AleksWolf/kryakva/docs/datasheets/README.md

# Manufacturer documents

The manufacturer documents are published unchanged. The rights to them belong to the manufacturers.

| File | What | Source |
|---|---|---|
| [radxa_zero_3w_3d_stp.zip](radxa_zero_3w_3d_stp.zip), [radxa_zero_3w_2d_dxf.zip](radxa_zero_3w_2d_dxf.zip) | 3D STEP and 2D DXF of the Radxa Zero 3W board (v1.11) | Radxa, dl.radxa.com |
| [camera_8m_219_product_brief.pdf](camera_8m_219_product_brief.pdf) | description of the Radxa Camera 8M 219 camera (IMX219) | Radxa, dl.radxa.com |
| [UC01-V1.6-SCH.pdf](UC01-V1.6-SCH.pdf) | schematic of the UC-01 servo bus board (v1.6) | Fashion Star, fashionstar.com.hk/wiki |
| [DS_vl53l8cx.pdf](DS_vl53l8cx.pdf) | datasheet of the VL53L8CX ToF sensor | STMicroelectronics |
| [feetech_hd1910/HD-1910-C001串型规格书-20260907.pdf](feetech_hd1910/HD-1910-C001串型规格书-20260907.pdf) | HD-1910-C001 servo specification (Chinese) | Feetech, from JoyandAI/OpenMicroDuck |
| [feetech_hd1910/HD-1910M-C001-drawing-20260902.pdf](feetech_hd1910/HD-1910M-C001-drawing-20260902.pdf) | HD-1910 outline drawing | Feetech, from JoyandAI/OpenMicroDuck |
