AleksWolf/kryakva/docs/datasheets/README.ru.md

# Документы производителей

Документы производителей выложены без изменений. Права на них принадлежат производителям.

| Файл | Что | Источник |
|---|---|---|
| [radxa_zero_3w_3d_stp.zip](radxa_zero_3w_3d_stp.zip), [radxa_zero_3w_2d_dxf.zip](radxa_zero_3w_2d_dxf.zip) | 3D STEP и 2D DXF платы Radxa Zero 3W (v1.11) | Radxa, dl.radxa.com |
| [camera_8m_219_product_brief.pdf](camera_8m_219_product_brief.pdf) | описание камеры Radxa Camera 8M 219 (IMX219) | Radxa, dl.radxa.com |
| [UC01-V1.6-SCH.pdf](UC01-V1.6-SCH.pdf) | схема платы шины серв UC-01 (v1.6) | Fashion Star, fashionstar.com.hk/wiki |
| [DS_vl53l8cx.pdf](DS_vl53l8cx.pdf) | даташит ToF-датчика VL53L8CX | STMicroelectronics |
| [feetech_hd1910/HD-1910-C001串型规格书-20260907.pdf](feetech_hd1910/HD-1910-C001串型规格书-20260907.pdf) | спецификация сервы HD-1910-C001 (кит.) | Feetech, из JoyandAI/OpenMicroDuck |
| [feetech_hd1910/HD-1910M-C001-drawing-20260902.pdf](feetech_hd1910/HD-1910M-C001-drawing-20260902.pdf) | габаритный чертёж HD-1910 | Feetech, из JoyandAI/OpenMicroDuck |
