AleksWolf/kryakva/hardware/cables.md

# Servo bus cables

19 AMP 2.0-3P cables, pin to pin (1–1, 2–2, 3–3): 9 from the servo boxes (15 cm), the rest as listed in [bom.md](bom.md).
For your own cables: 24 AWG wire, insulation no thicker than 1.50 mm (for the A2007-T terminal), A2007H-3P housings.

| No. | Chain | From → to | Cable | Qty |
|---|---|---|---|---|
| 1 | leg (L and R) | PCB L / R → hip yaw (ID 20 / 10) | 4 cm | 2 |
| 2 | leg | yaw → hip roll (20→21, 10→11) | 15 cm (from the box) | 2 |
| 3 | leg | roll → hip pitch (21→22, 11→12) | 15 cm (from the box) | 2 |
| 4 | leg | hip pitch → knee (22→23, 12→13) | 6 cm | 2 |
| 5 | leg | knee → ankle (23→24, 13→14) | 15 cm (from the box) | 2 |
| 6 | leg | PCB L PWR / R PWR → free port of the ankle (24 / 14) | 20 cm | 2 |
| 7 | head | UC-01 port 1 → beak (34) | 15 cm (from the box) | 1 |
| 8 | head | beak → head roll (34→33) | 15 cm (from the box) | 1 |
| 9 | head | roll → head yaw (33→32) | 6 cm | 1 |
| 10 | head | yaw → head pitch (32→31) | 15 cm (from the box) | 1 |
| 11 | head | head pitch → neck pitch (31→30) | 4 cm | 1 |
| 12 | UC-01 power | UC-01 port 2 → PCB, UC-01 connector | 25 cm | 1 |
| 13 | neck power | PCB pads → free port of servo 30; connector on the servo end only | 9 cm | 1 |
