AleksWolf/kryakva/hardware/cables.ru.md

# Кабели шины серв

19 кабелей AMP 2.0-3P, контакт в контакт (1–1, 2–2, 3–3): 9 из коробок серв (15 см), остальные — по списку в [bom.md](bom.ru.md).
Для своих кабелей: провод 24 AWG, изоляция не толще 1.50 мм (под клемму A2007-T), корпуса A2007H-3P.

| № | Цепочка | Откуда → куда | Кабель | Шт. |
|---|---|---|---|---|
| 1 | нога (L и R) | PCB L / R → рыскание бедра (ID 20 / 10) | 4 см | 2 |
| 2 | нога | рыскание → крен бедра (20→21, 10→11) | 15 см (из коробки) | 2 |
| 3 | нога | крен → тангаж бедра (21→22, 11→12) | 15 см (из коробки) | 2 |
| 4 | нога | тангаж бедра → колено (22→23, 12→13) | 6 см | 2 |
| 5 | нога | колено → голеностоп (23→24, 13→14) | 15 см (из коробки) | 2 |
| 6 | нога | PCB L PWR / R PWR → свободный порт голеностопа (24 / 14) | 20 см | 2 |
| 7 | голова | UC-01 порт 1 → клюв (34) | 15 см (из коробки) | 1 |
| 8 | голова | клюв → крен головы (34→33) | 15 см (из коробки) | 1 |
| 9 | голова | крен → рыскание головы (33→32) | 6 см | 1 |
| 10 | голова | рыскание → тангаж головы (32→31) | 15 см (из коробки) | 1 |
| 11 | голова | тангаж головы → тангаж шеи (31→30) | 4 см | 1 |
| 12 | питание UC-01 | UC-01 порт 2 → PCB, разъём UC-01 | 25 см | 1 |
| 13 | питание шеи | площадки PCB → свободный порт сервы 30; вилка только со стороны сервы | 9 см | 1 |
