AleksWolf/kryakva/docs/images/duck_back.png

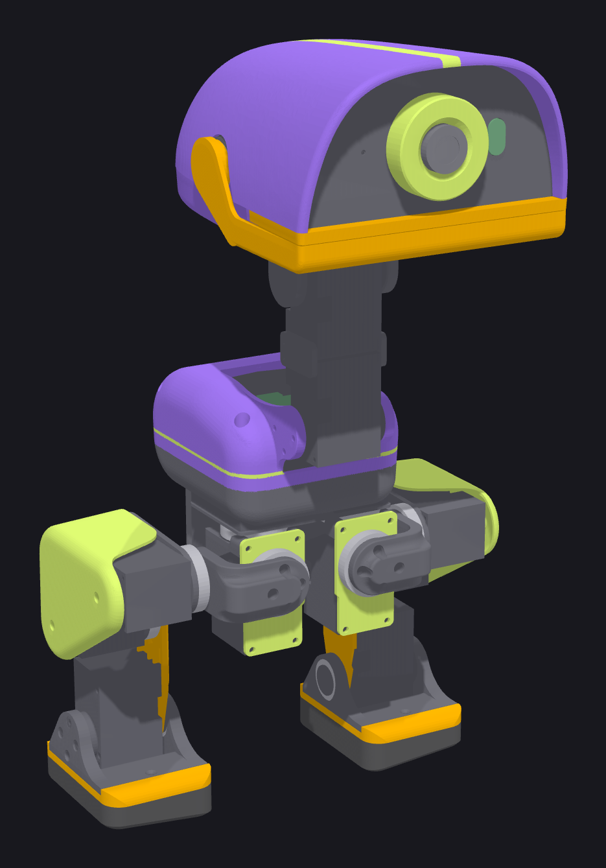
docs/images/duck_back.png
