AleksWolf/kryakva/hardware/images/amp20_header.png

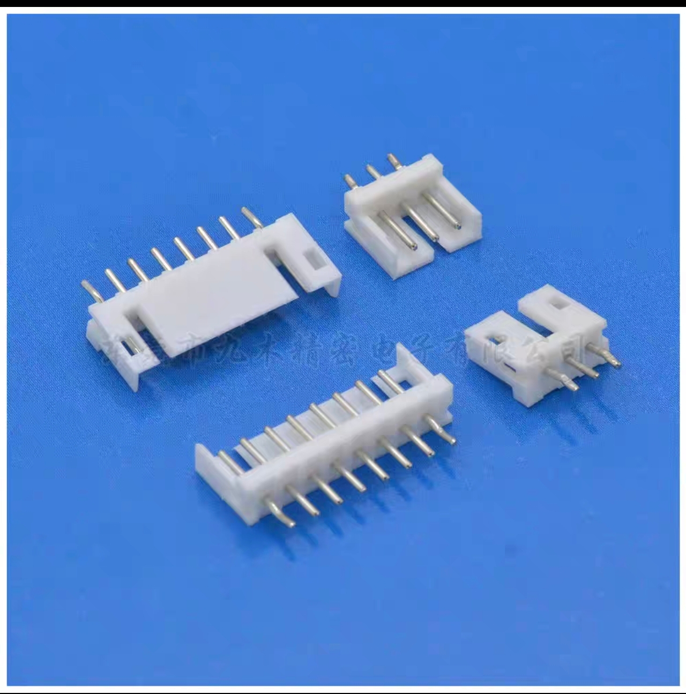
hardware/images/amp20_header.png
