AleksWolf/kryakva/hardware/images/bearing_6700.png

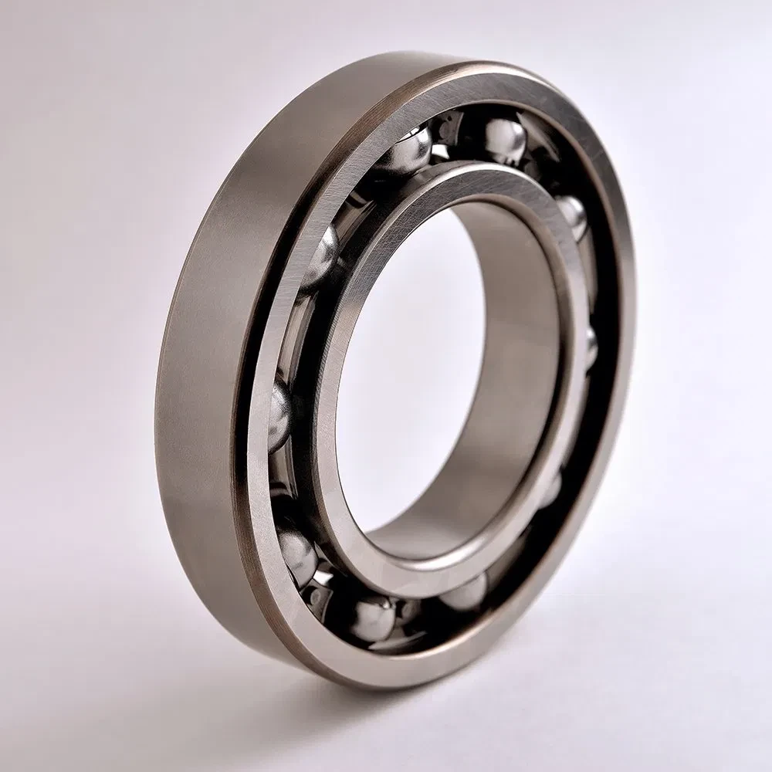
hardware/images/bearing_6700.png
