AleksWolf/kryakva/hardware/images/camera8m219.png

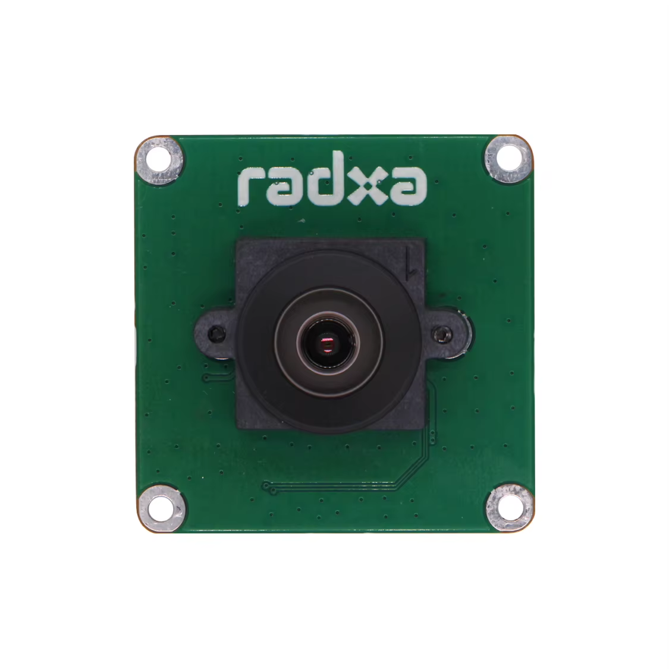
hardware/images/camera8m219.png
