AleksWolf/kryakva/hardware/images/gamepad.png

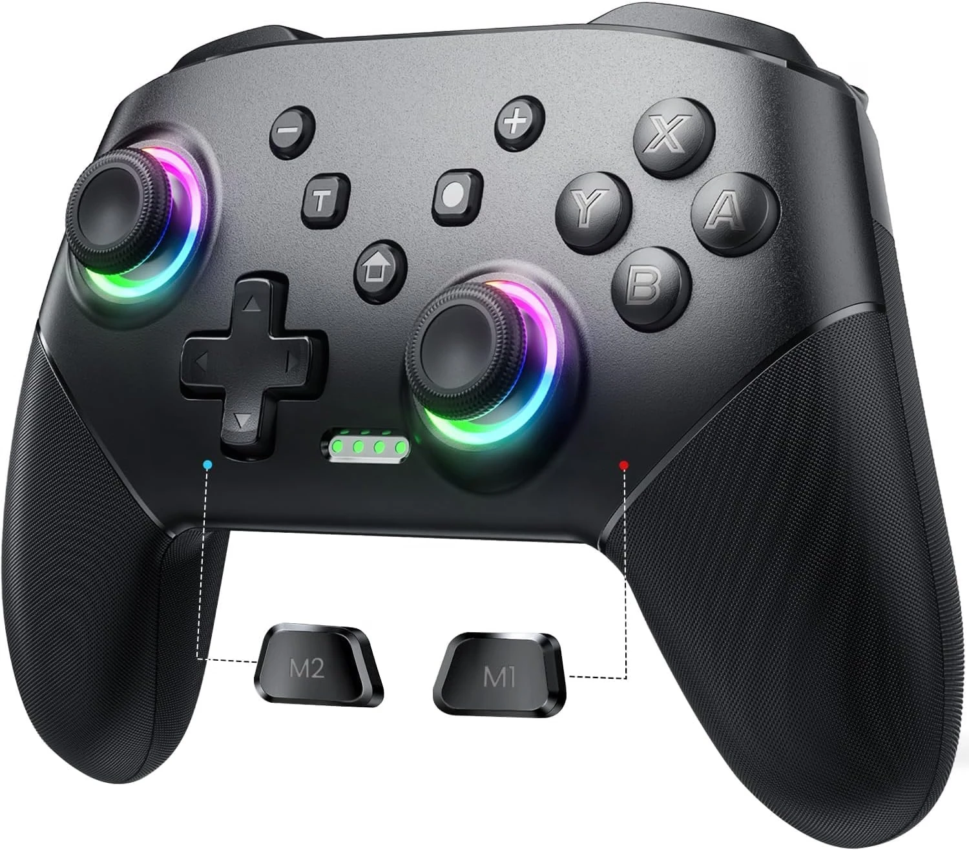
hardware/images/gamepad.png
