AleksWolf/kryakva/hardware/images/hd1910.png

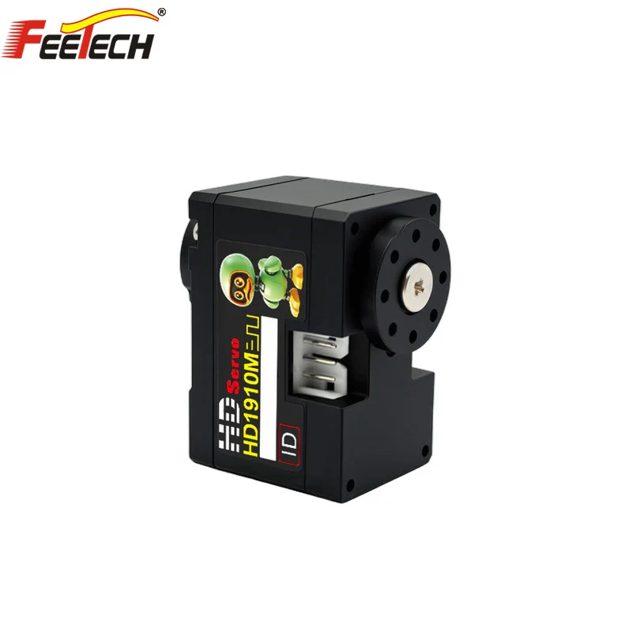
hardware/images/hd1910.png
