AleksWolf/kryakva/hardware/images/heat_insert.png

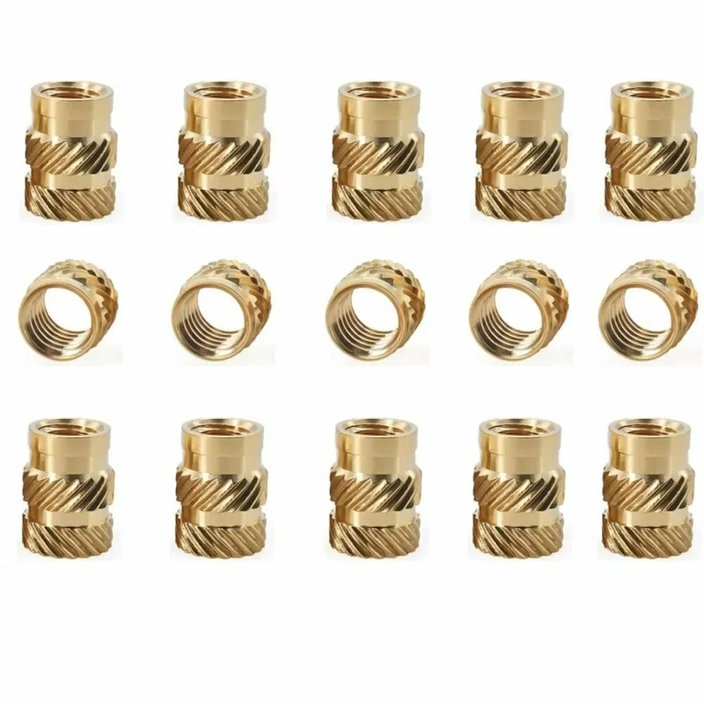
hardware/images/heat_insert.png
