AleksWolf/kryakva/hardware/images/heatsink5519a.png

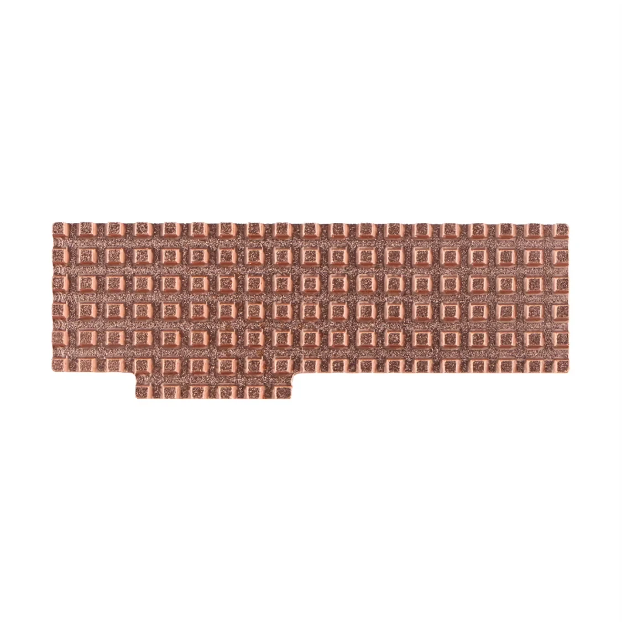
hardware/images/heatsink5519a.png
