AleksWolf/kryakva/hardware/images/ics43434.png

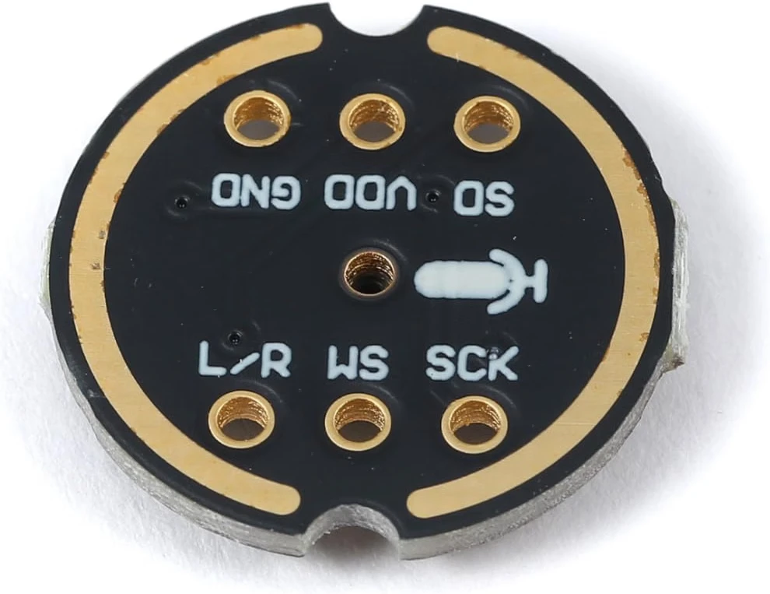
hardware/images/ics43434.png
