AleksWolf/kryakva/hardware/images/lsm6dsv16x.png

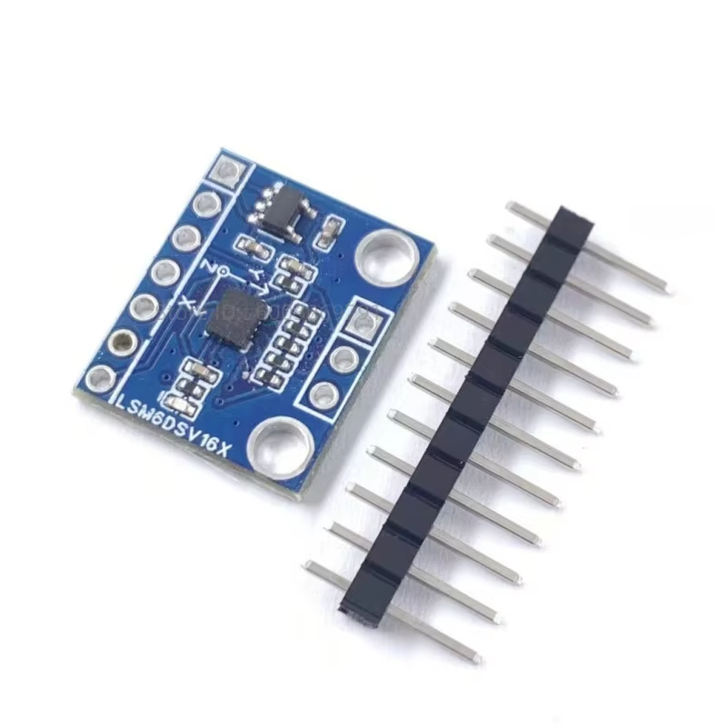
hardware/images/lsm6dsv16x.png
