AleksWolf/kryakva/hardware/images/max98357a.png

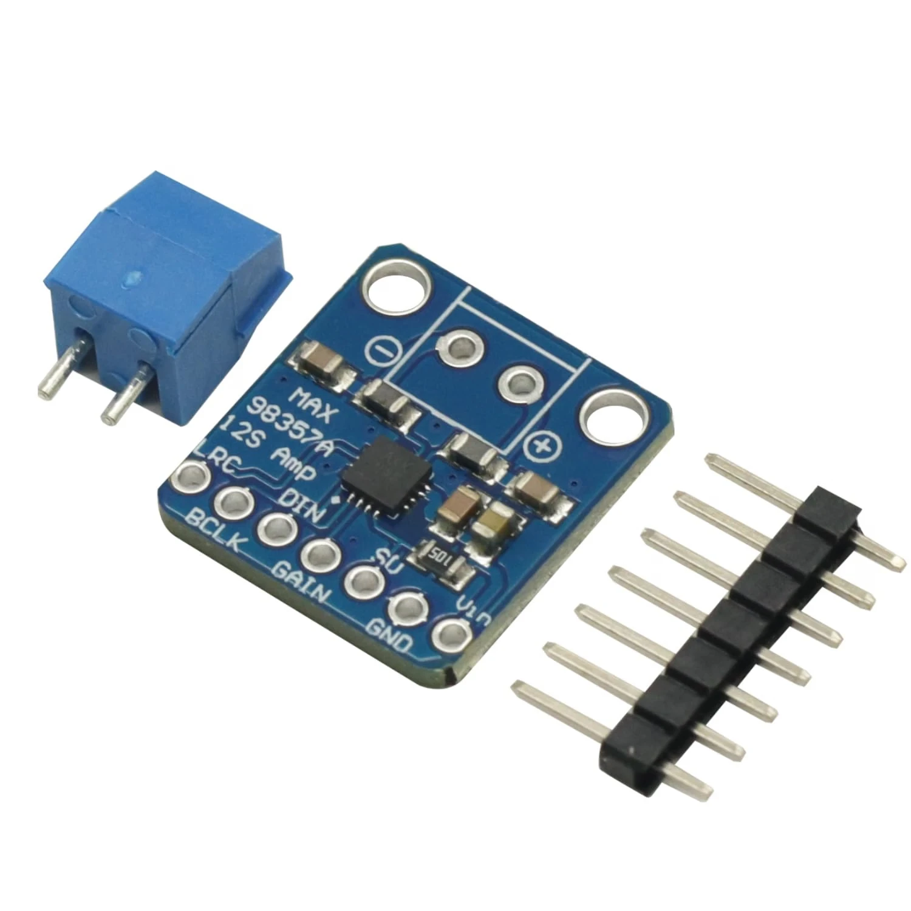
hardware/images/max98357a.png
