AleksWolf/kryakva/hardware/images/microsd.png

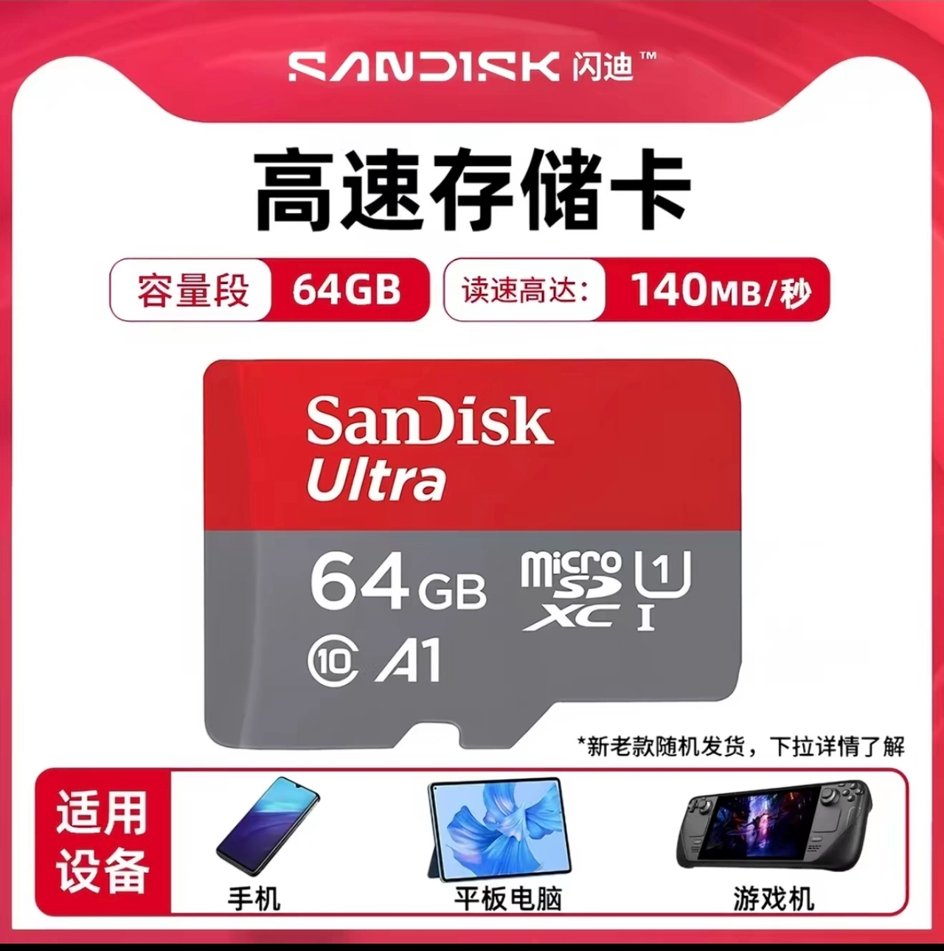
hardware/images/microsd.png
