AleksWolf/kryakva/hardware/images/mr126zz.png

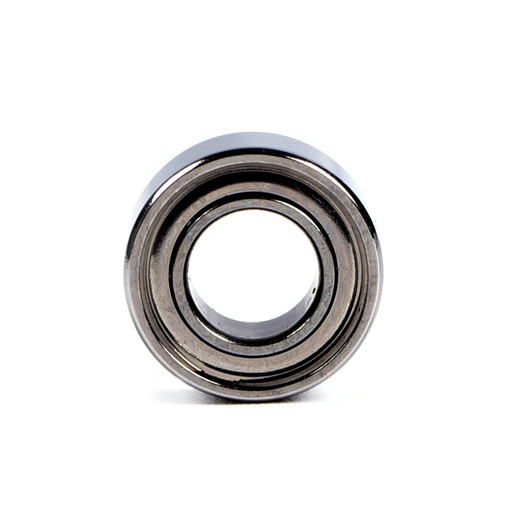
hardware/images/mr126zz.png
