AleksWolf/kryakva/hardware/images/mr2216_2rs.png

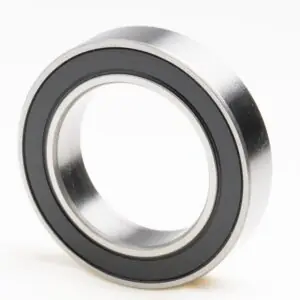
hardware/images/mr2216_2rs.png
