AleksWolf/kryakva/hardware/images/npf550c.png

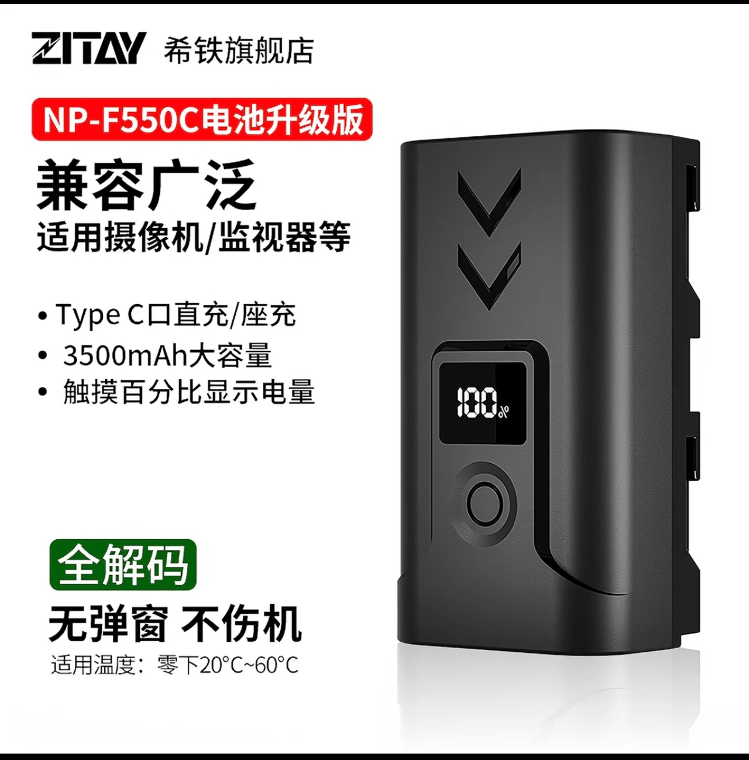
hardware/images/npf550c.png
