AleksWolf/kryakva/hardware/images/npf_charger.png

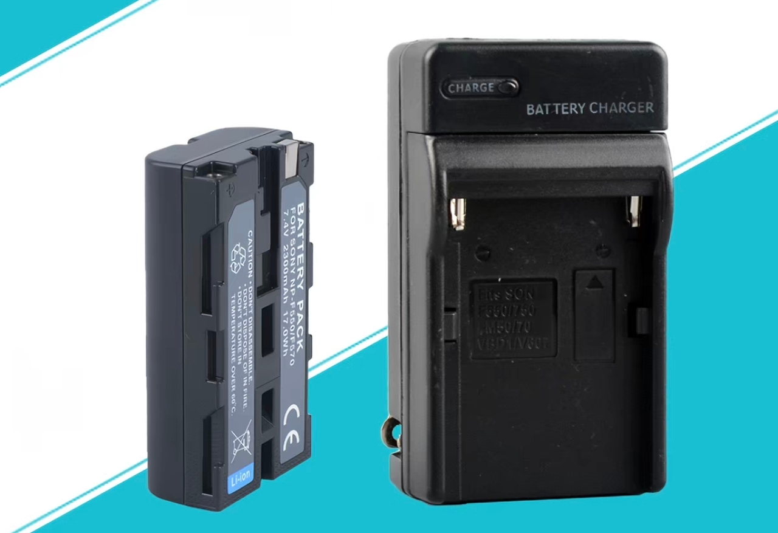
hardware/images/npf_charger.png
