AleksWolf/kryakva/hardware/images/screw_csk.png

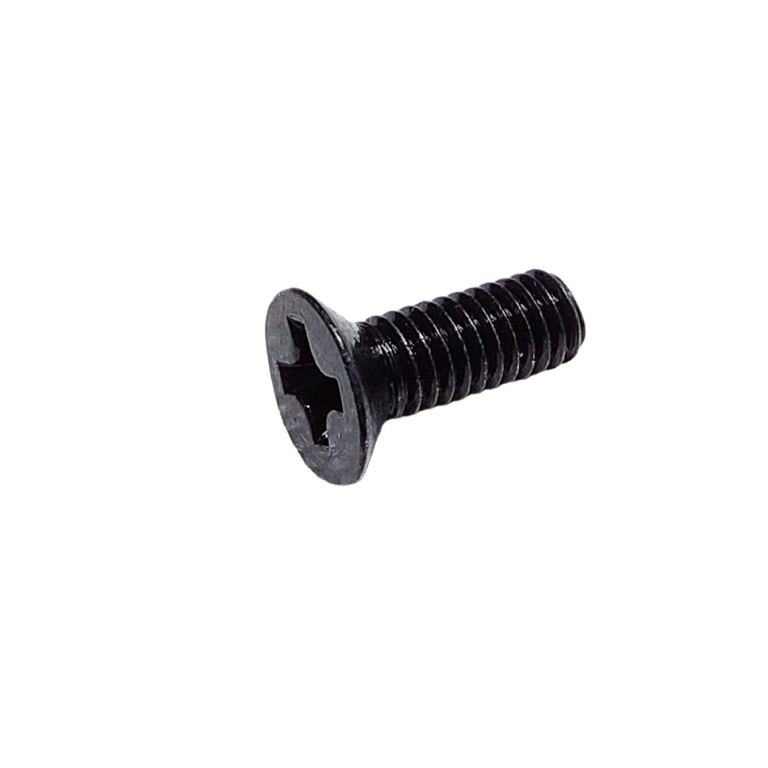
hardware/images/screw_csk.png
