AleksWolf/kryakva/hardware/images/screw_hex.png

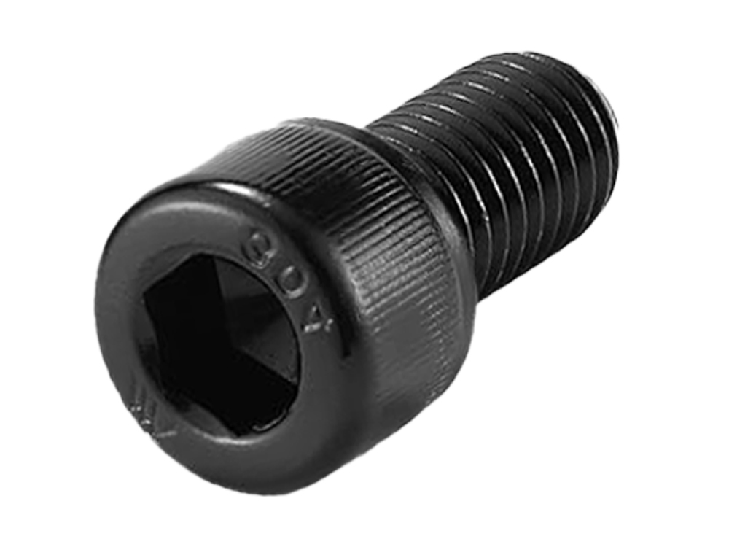
hardware/images/screw_hex.png
