AleksWolf/kryakva/hardware/images/self_tap.png

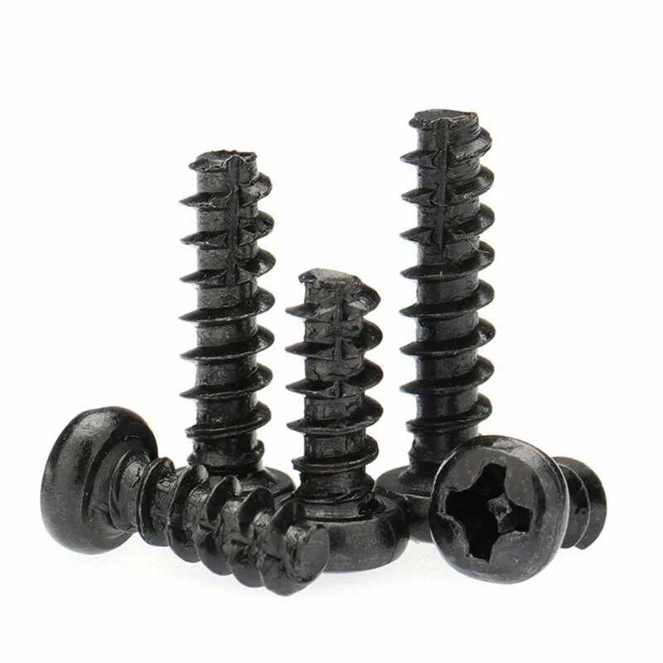
hardware/images/self_tap.png
