AleksWolf/kryakva/hardware/images/speaker3525.png

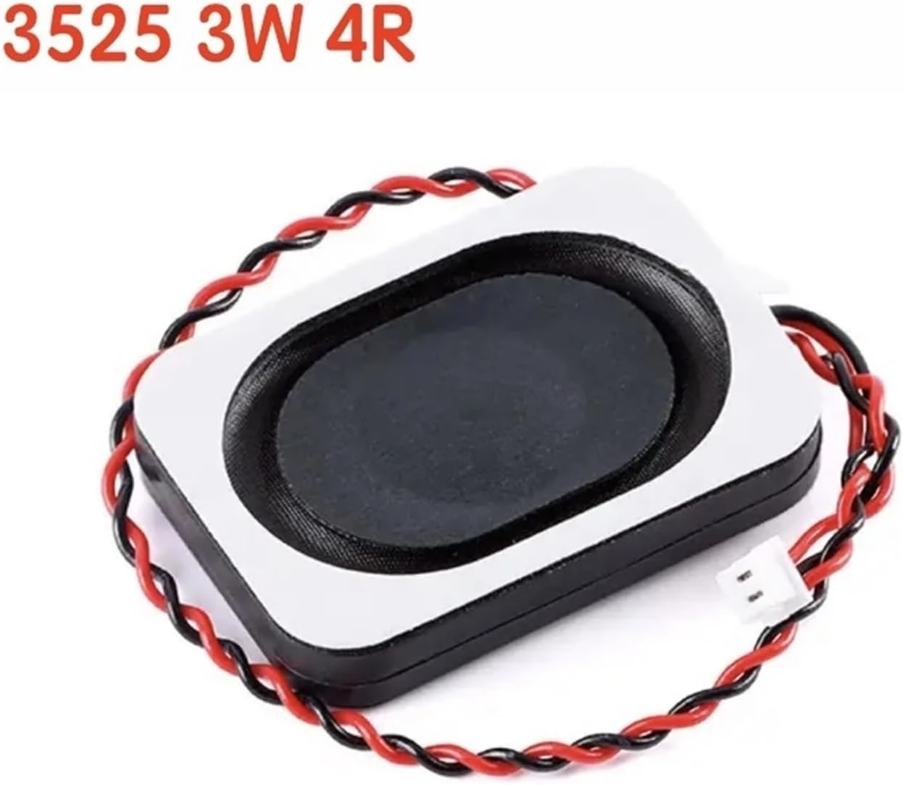
hardware/images/speaker3525.png
