AleksWolf/kryakva/hardware/images/ubec.png

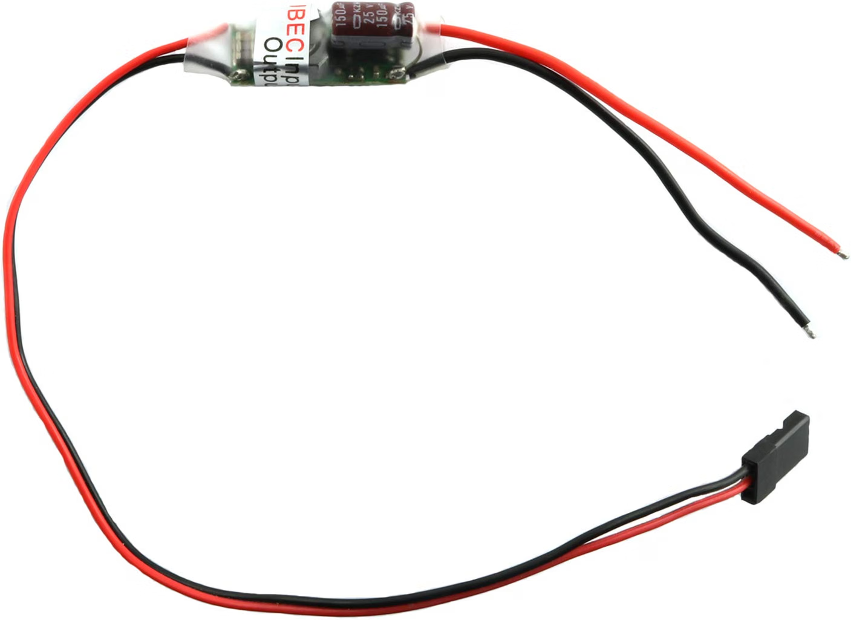
hardware/images/ubec.png
