AleksWolf/kryakva/hardware/images/uc01.png

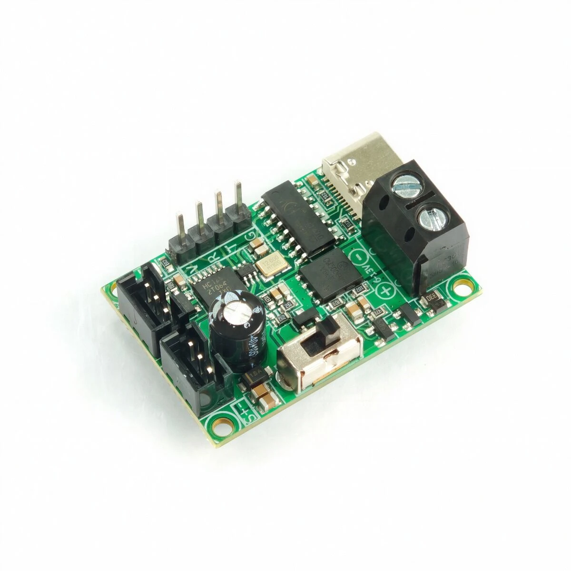
hardware/images/uc01.png
