AleksWolf/kryakva/hardware/images/vl53l8cx.png

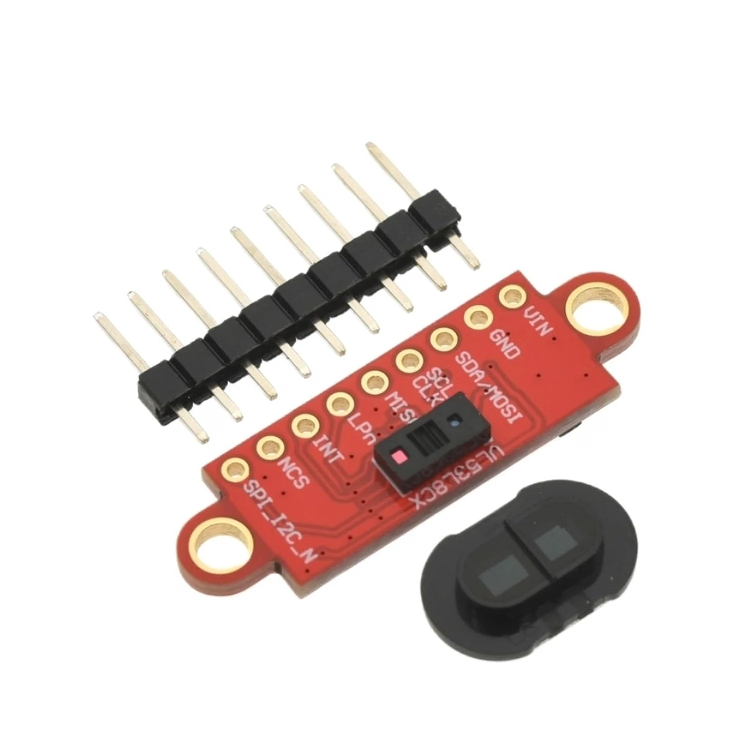
hardware/images/vl53l8cx.png
