AleksWolf/kryakva/hardware/images/zero3w.png

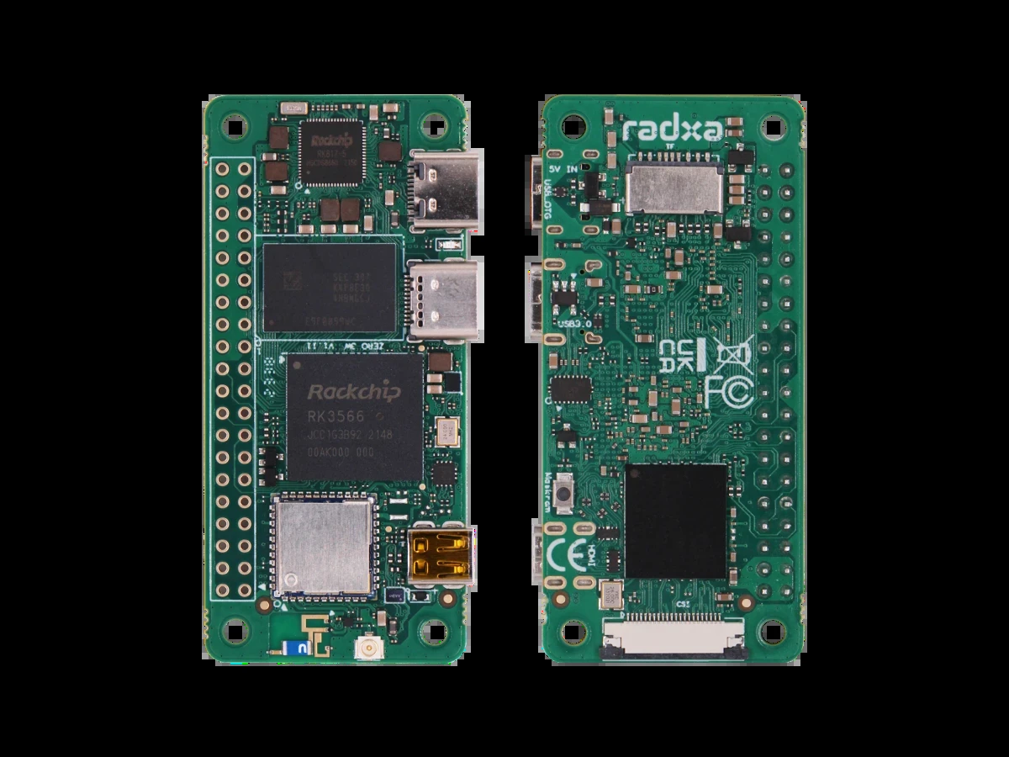
hardware/images/zero3w.png
