AleksWolf/kryakva/hardware/power_board/power_board_drawing.png

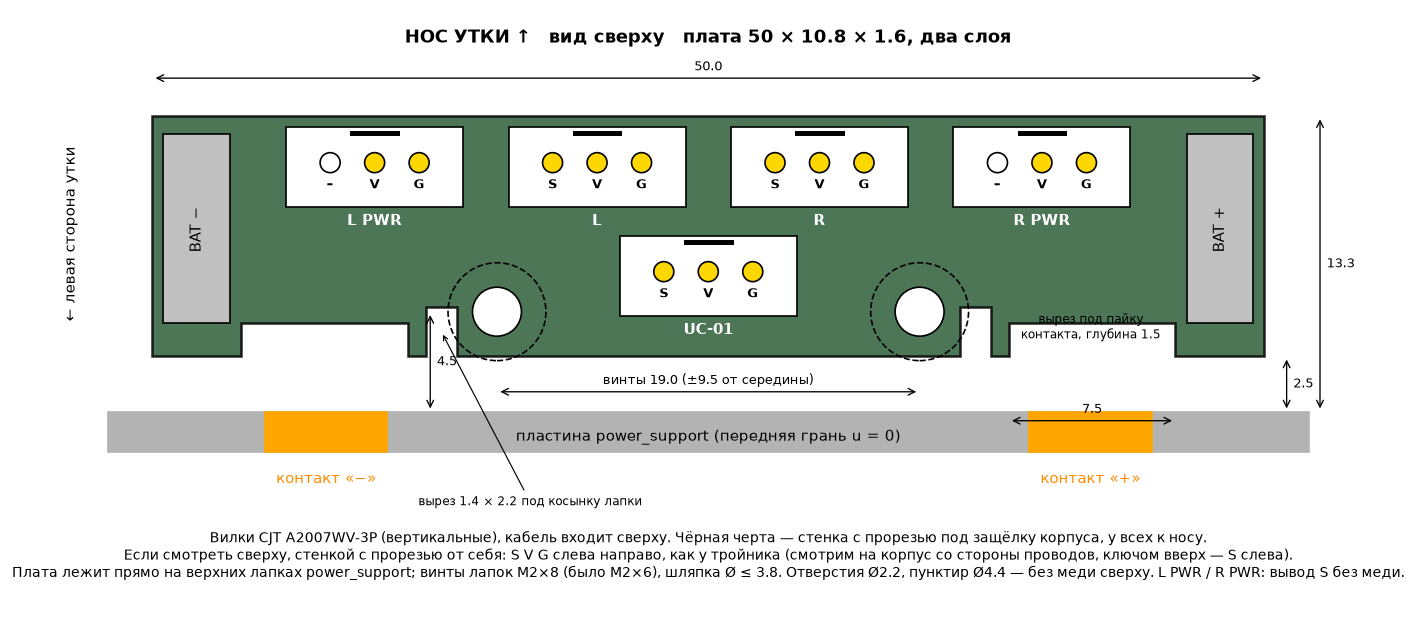
hardware/power_board/power_board_drawing.png
