AleksWolf/kryakva/hardware/uc01_plugs.png

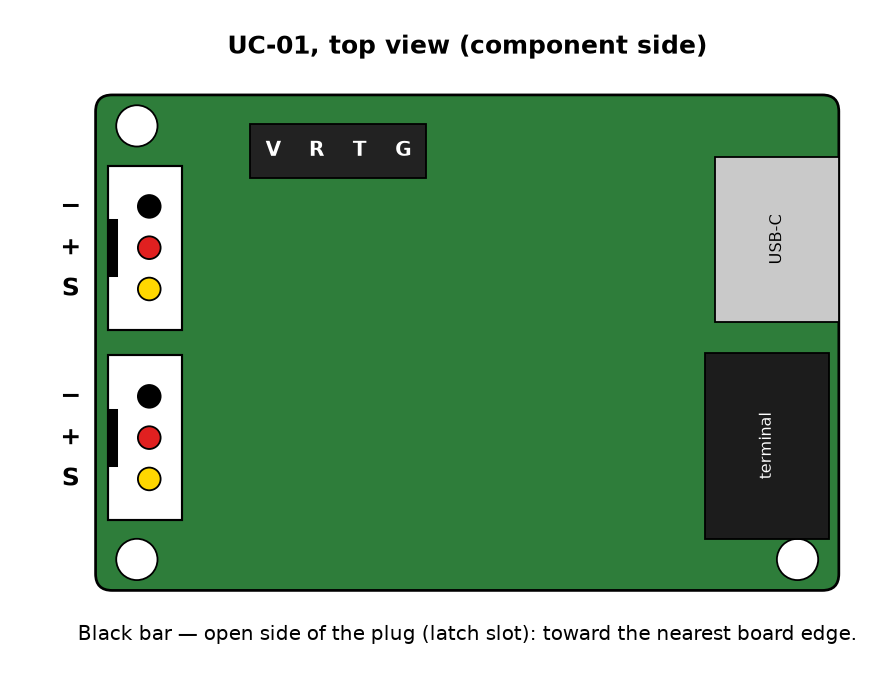
hardware/uc01_plugs.png
