AleksWolf/kryakva/hardware/uc01_plugs.ru.png

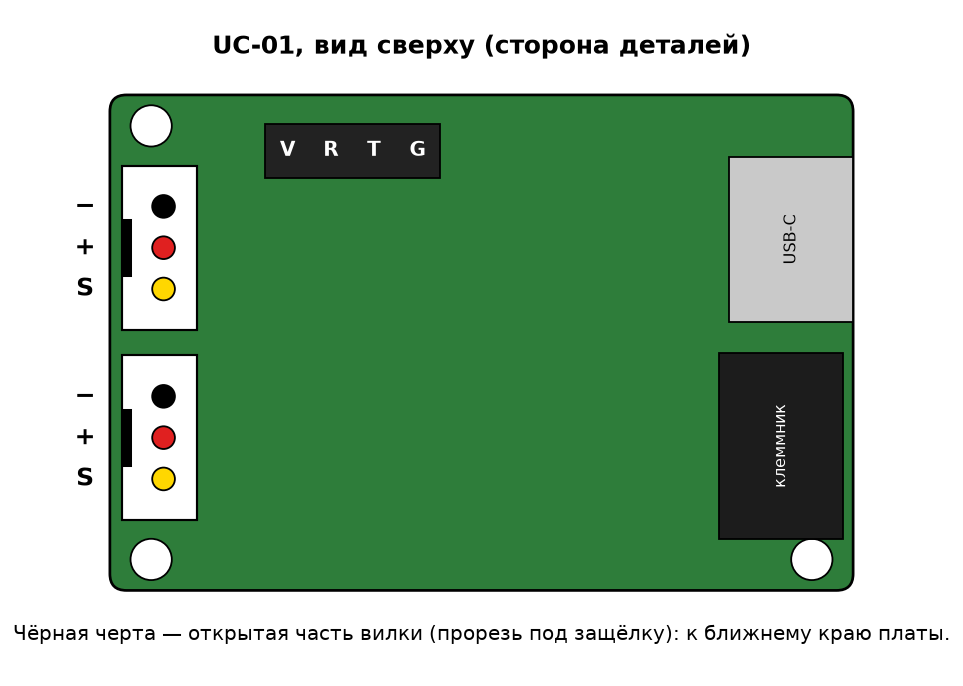
hardware/uc01_plugs.ru.png
