AleksWolf/kryakva/cad/parts.ru.md

# Печатные детали

Все детали — в двух сборках: [cad/assembly.step](assembly.step) (утка в сборе) и [cad/assembly_rollers.step](assembly_rollers.step) (на роликах).
Правые детали — зеркальные копии левых. Количества в таблице — на одну утку, те же стоят в профилях [print/](../print/README.ru.md).

## Детали

| Деталь | Шт. | Материал |
|---|---|---|
| `trunk_base` | 1 | PLA |
| `left_shell`, `right_shell` | 1 + 1 | PLA |
| `power_support` | 1 | PLA |
| `neck` | 2 | PLA |
| `hip` | 2 | PLA |
| `yaw2roll` | 2 | PLA |
| `bearing_roll` | 2 | PLA |
| `upper_leg_left`, `upper_leg_right` | 1 + 1 | PLA |
| `leg` | 2 | PLA |
| `rigidity_plate` | 2 | PLA |
| `ankle_left`, `ankle_right` | 1 + 1 | PLA |
| `ankle_axle` | 2 | PLA |
| `foot_left`, `foot_right` | 1 + 1 | PLA |
| `sole_left`, `sole_right` | 1 + 1 | TPU |
| `neck_pitch` | 1 | PLA |
| `bearing_neck` | 1 | PLA |
| `yaw_roll_motion` | 1 | PLA |
| `motor_support` | 1 | PLA |
| `face_part` | 1 | PLA |
| `top_head_shell` | 1 | PLA |
| `bottom_head_shell` | 1 | PLA |
| `noenoeil` | 1 | PLA |
| `jaw` | 1 | PLA |
| `jaw_soft` | 1 | TPU |
| `soft_mouth_top` | 1 | TPU |
| `zero clamp` | 1 | ASA |
| `roller` | 2 | PLA |
| `bushing` | 4 | PLA |
| `rim` | 4 | PLA |
| `tire` | 4 | TPU |

## Термовставки

| Вставка | Шт. | Куда |
|---|---|---|
| M2 × 4 × Ø3 | 13 | стопы 2 (носок), `top_head_shell` 5 (3 бобышки + 2 стойки UC-01), `face_part` 4 (стойки Zero 3W), ролики 2 (носки) |
| M2 × 3 × Ø3.2 | 9 | `face_part` 6 (камера 4, ToF 2), `motor_support` 2 (усилитель), `right_shell` 1 (стык половин) |

Вставки вплавляются до сборки, вровень с гранью.

## Подшипники

| Подшипник | Шт. | Где |
|---|---|---|
| MR2216-2RS, 16 × 22 × 4 | 11 | рыскание и крен бедра, тангаж бедра, колено (по 1 на ногу), тангаж шеи, рыскание и крен головы |
| 6700 открытый, 10 × 15 × 3 | 3 | голеностопы 2, клюв 1 |
| MR126ZZ, 6 × 12 × 4 | 8 | колёса роликов, по 2 в колесо |

## Крепёж

Винты M2 — под шестигранник, если не сказано иное. Раскладка по стыкам — в инструкции сборки ([docs/assembly](../docs/assembly/index.ru.html)).

| Крепёж | Шт. |
|---|---|
| M2 × 4 | 32 |
| M2 × 6 | 87 |
| M2 × 8 | 7 |
| M2 × 12 | 4 |
| M2.5 × 6 | 4 |
| M2.5 × 6 потайной | 2 (IMU) |
| M2 × 6 потайной | 2 (носки стоп) |
| M2.5 × 14 | 4 (оси колёс) |
| саморез M2.3 × 4 | 4 (upper_leg → задние бобышки серв) |
| саморез M2.3 × 6 | 2 (ось лодыжки → задняя бобышка сервы) |
| саморез Ø1.36 × 3.3 | 2 (контакты батареи, из комплекта зарядного устройства) |
| двусторонняя клейкая лента на бумажной основе | мягкие вставки клюва |
| хомут нейлоновый, самый короткий | 2 (кабель 20 см к краю отверстия над сервой колена) |

Где нет термовставки, винт M2 режет резьбу прямо в пластике. В резьбу качалки сервы винт входит не глубже 2.5 мм: на 3 мм он упирается в корпус сервы.
