AleksWolf/kryakva/cad/assembly_rollers.step

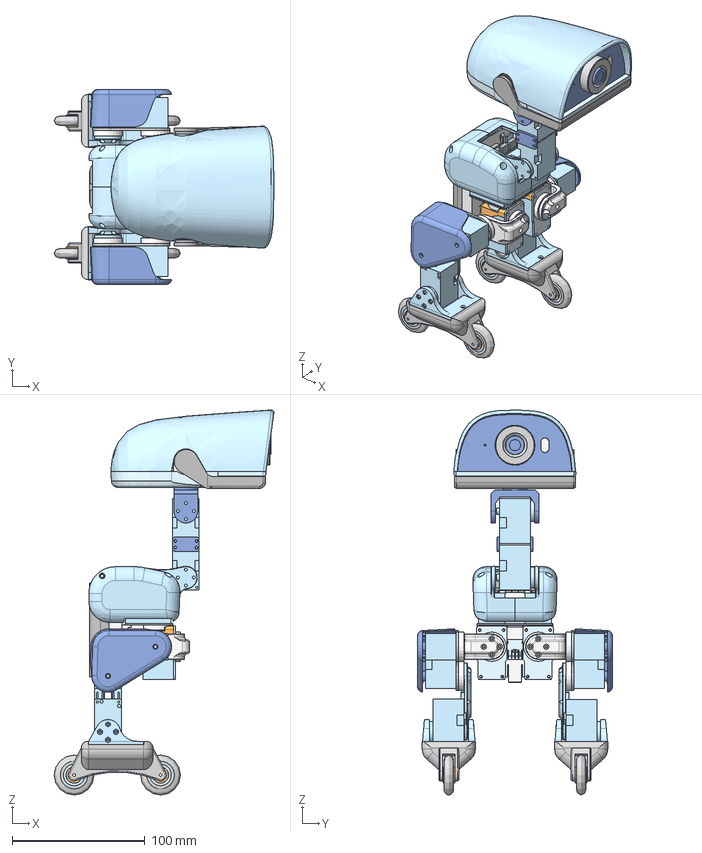
[picture p47: CAD file, 2026-11-09]
cad/assembly_rollers.step
165.2 x 146.5 x 289.6 mm
rim x 4
ankle_left
yaw_roll_motion
bearing_22x16x4_simplified x 11
bearing_12x6x4_simplified x 8
hd1910_servo_simplified x 15
tof_vl53l8cx_board_simplified
tire x 4
face_part
mic_ics43434_round_simplified
right_shell
imu_lsm6dsv16x_module_simplified
power_support
soft_mouth_top
ankle_right
bearing_15x10x3_simplified x 3
jaw
bearing_roll x 2
camera_8m_219_simplified
top_head_shell
neck x 2
neck_pitch
yaw2roll x 2
speaker_2535_simplified
bushing x 4
motor_support
np-f550
rigidity_plate x 2
roller x 2
leg x 2
jaw_soft
uc01_simple
radxa_zero_3w_simplified
trunk_base
ankle_axle x 2
zero clamp
bearing_neck
power_board_simplified
hip x 2
max98357a_module_simplified
bottom_head_shell
left_shell
noenoeil
upper_leg_left
upper_leg_right
