AleksWolf/kryakva/cad/assembly.step

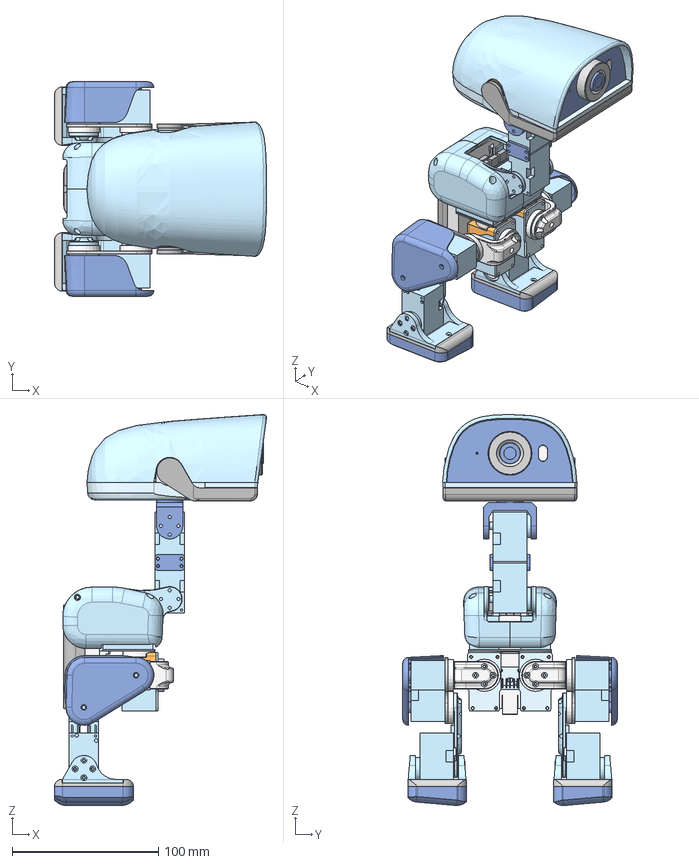
[picture p48: CAD file, 2026-11-09]
cad/assembly.step
144.8 x 146.5 x 267.0 mm
foot_right
ankle_left
yaw_roll_motion
bearing_22x16x4_simplified x 11
hd1910_servo_simplified x 15
tof_vl53l8cx_board_simplified
face_part
mic_ics43434_round_simplified
right_shell
imu_lsm6dsv16x_module_simplified
power_support
soft_mouth_top
ankle_right
jaw
bearing_15x10x3_simplified x 3
bearing_roll x 2
camera_8m_219_simplified
sole_right
top_head_shell
neck x 2
neck_pitch
yaw2roll x 2
speaker_2535_simplified
motor_support
np-f550
rigidity_plate x 2
leg x 2
jaw_soft
uc01_simple
radxa_zero_3w_simplified
foot_left
trunk_base
ankle_axle x 2
bearing_neck
power_board_simplified
hip x 2
max98357a_module_simplified
bottom_head_shell
left_shell
noenoeil
upper_leg_left
zero clamp
upper_leg_right
sole_left
