AleksWolf/kryakva/print/microduck-x2d-0.6.3mf

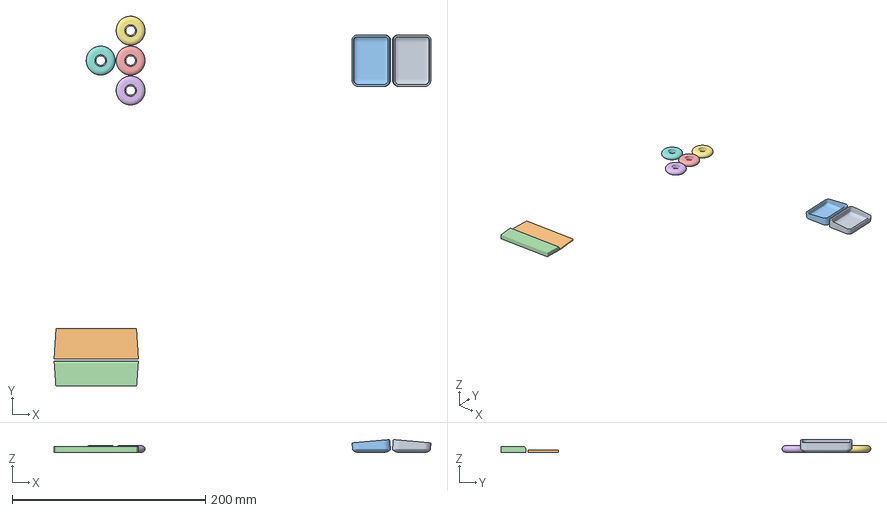
[picture p49: CAD file, 2026-11-09]
print/microduck-x2d-0.6.3mf
390.4 x 382.8 x 13.4 mm
ankles - sole_left.stl
head - soft_mouth_top.stl
ankles - sole_right.stl
head - jaw_soft.stl
Сборка x 4
