AleksWolf/kryakva/training/model/assets/hip_l.stl

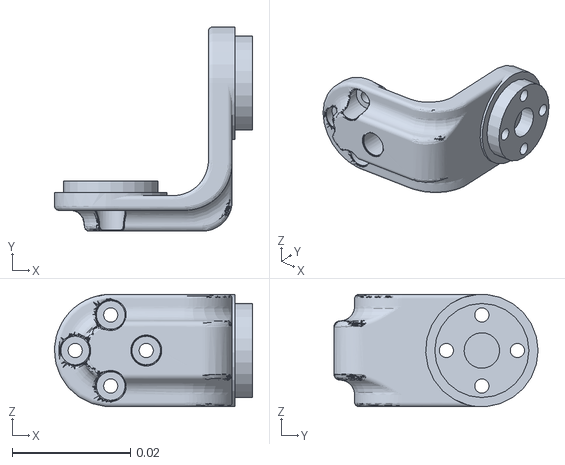
[picture p50: CAD file, 2026-11-09]
training/model/assets/hip_l.stl
0.0334 x 0.0345 x 0.019
