AleksWolf/kryakva/training/model/rollers/assets/speaker_2535.stl

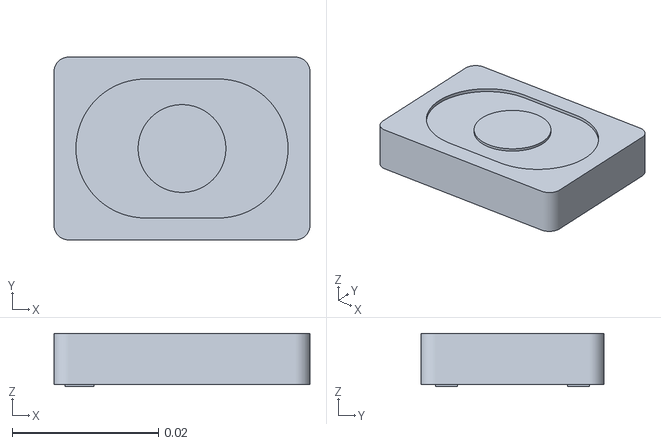
[picture p51: CAD file, 2026-11-09]
training/model/rollers/assets/speaker_2535.stl
0.035 x 0.025 x 0.0073
