AleksWolf/kryakva/cad/calibration_plate.step

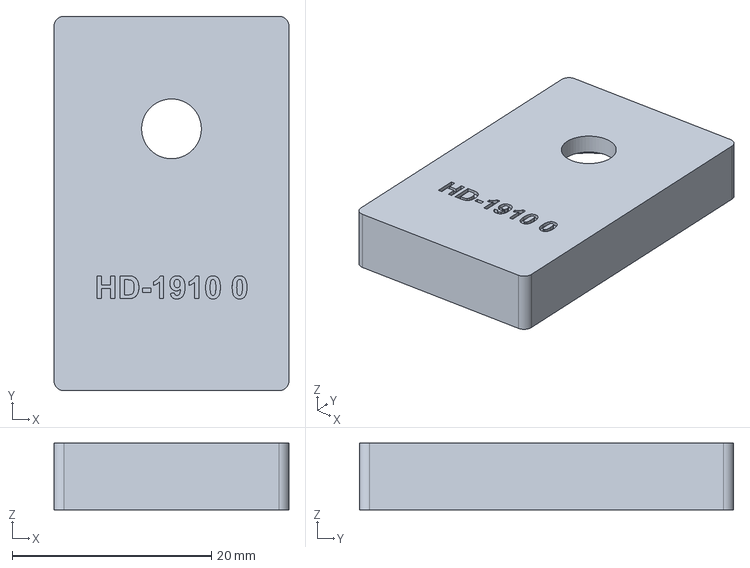
[picture p52: CAD file, 2026-11-09]
cad/calibration_plate.step
23.6 x 37.6 x 6.70 mm
