AleksWolf/kryakva/print/microduck-p2s-0.4.3mf

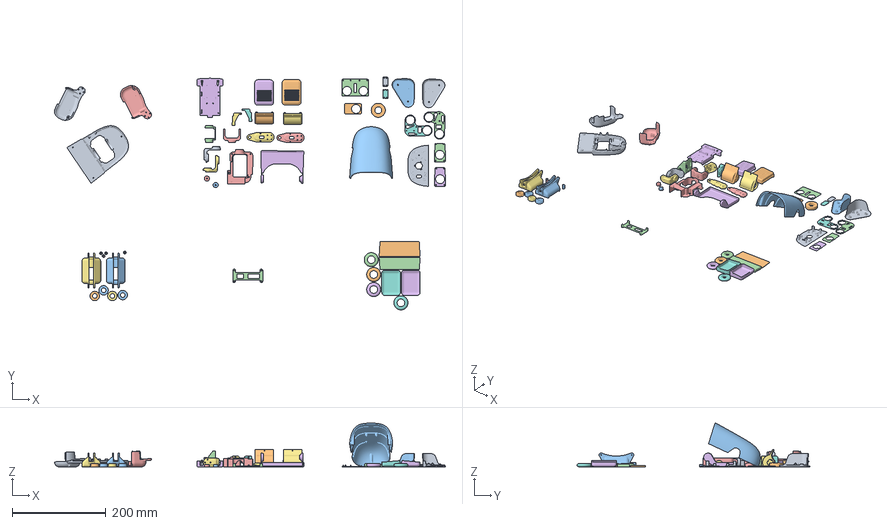
[picture p53: CAD file, 2026-11-09]
print/microduck-p2s-0.4.3mf
832.3 x 495.5 x 93.1 mm
legs - upper_leg_right.stl
head - soft_mouth_top.stl
rollers - roller.stl x 2
head - jaw_soft.stl
left_shell.stl
ankles - sole_left.stl
ankles - sole_right.stl
head - bottom_head_shell.stl
wheel - tire.stl x 4
wheel - rim.stl x 4
head - motor_support.stl
body - right_shell.stl
body - trunk_base.stl
rollers - bushing.stl x 4
body - power_support.stl
ankles - ankle_right.stl
ankles - ankle_left.stl
head - yaw_roll_motion.stl
head - neck_pitch.stl
head - jaw.stl
legs - yaw2roll.stl x 2
head - face_part.stl
head - noenoeil.stl
legs - upper_leg_left.stl
legs - rigidity_plate.stl x 2
legs - leg.stl x 2
ankles - foot_right.stl
legs - hip.stl x 2
ankles - foot_left.stl
ankles - ankle_axle.stl x 2
legs - bearing_roll.stl x 2
body - neck.stl x 2
head - bearing_neck.stl
head - top_head_shell.stl
sp - zero clamp.stl
