AleksWolf/kryakva/training/model/assets/neck_pitch.stl

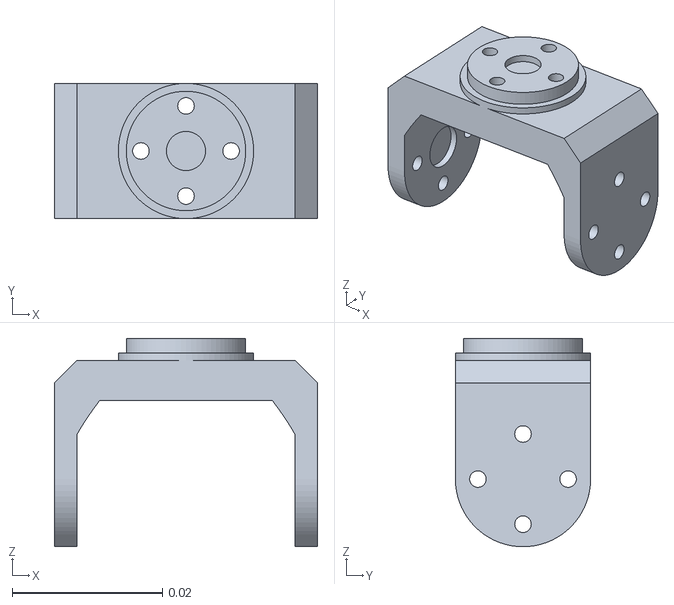
[picture p54: CAD file, 2026-11-09]
training/model/assets/neck_pitch.stl
0.035 x 0.018 x 0.0277
