AleksWolf/kryakva/training/model/rollers/assets/tire.stl

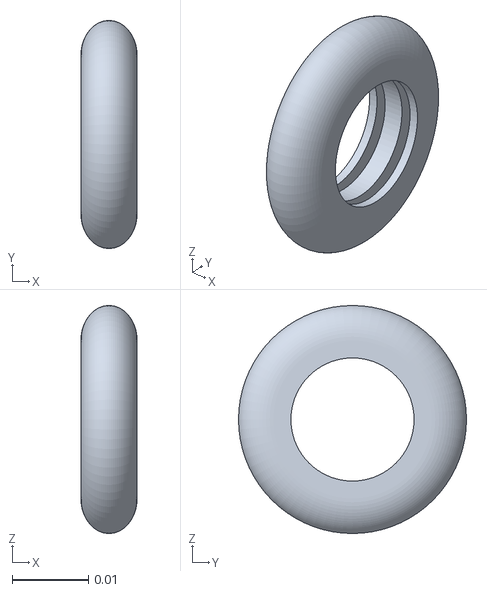
[picture p55: CAD file, 2026-11-09]
training/model/rollers/assets/tire.stl
0.0074 x 0.03 x 0.03
