AleksWolf/kryakva/print/microduck-x2d-0.4.3mf

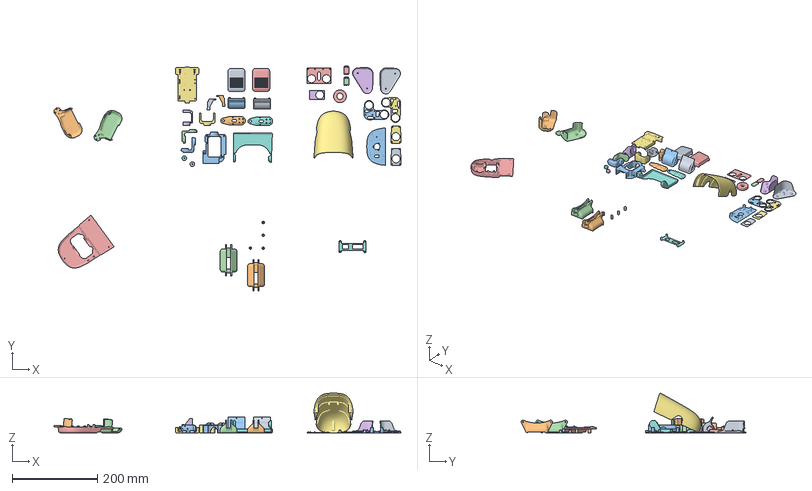
[picture p56: CAD file, 2026-11-09]
print/microduck-x2d-0.4.3mf
813.5 x 526.9 x 93.1 mm
legs - upper_leg_right.stl
rollers - bushing.stl x 4
head - motor_support.stl
body - trunk_base.stl
body - power_support.stl
ankles - ankle_right.stl
rollers - roller.stl x 2
ankles - ankle_left.stl
head - bottom_head_shell.stl
head - yaw_roll_motion.stl
head - neck_pitch.stl
head - jaw.stl
legs - yaw2roll.stl x 2
head - face_part.stl
body - right_shell.stl
head - noenoeil.stl
legs - upper_leg_left.stl
legs - rigidity_plate.stl x 2
legs - leg.stl x 2
ankles - foot_right.stl
legs - hip.stl x 2
ankles - foot_left.stl
ankles - ankle_axle.stl x 2
legs - bearing_roll.stl x 2
left_shell.stl
body - neck.stl x 2
head - bearing_neck.stl
head - top_head_shell.stl
sp - zero clamp.stl
