AleksWolf/kryakva/training/model/assets/ankle_right.stl

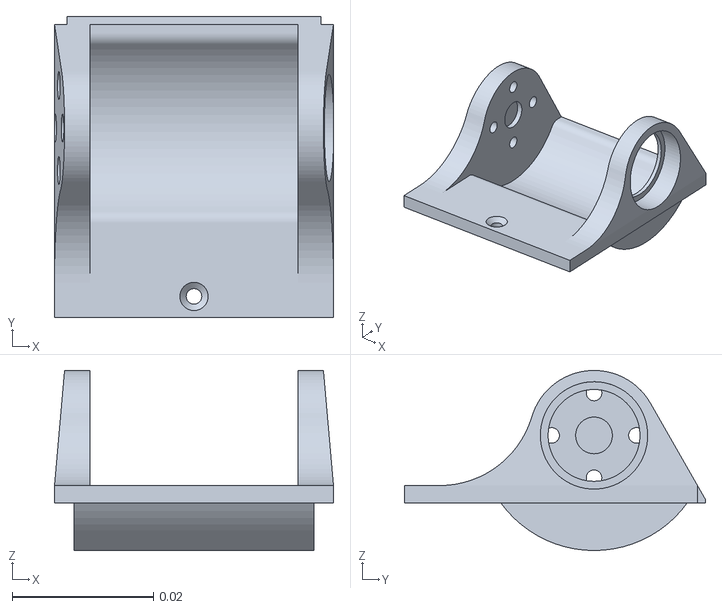
[picture p57: CAD file, 2026-11-09]
training/model/assets/ankle_right.stl
0.0395 x 0.0426 x 0.0255
