AleksWolf/kryakva/training/model/rollers/assets/bus_servo.stl

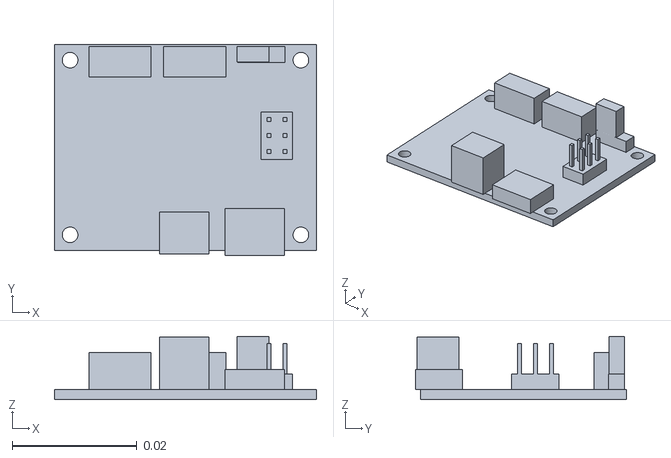
[picture p58: CAD file, 2026-11-09]
training/model/rollers/assets/bus_servo.stl
0.042 x 0.0338 x 0.0101
