AleksWolf/kryakva/training/model/assets/right_shell.stl

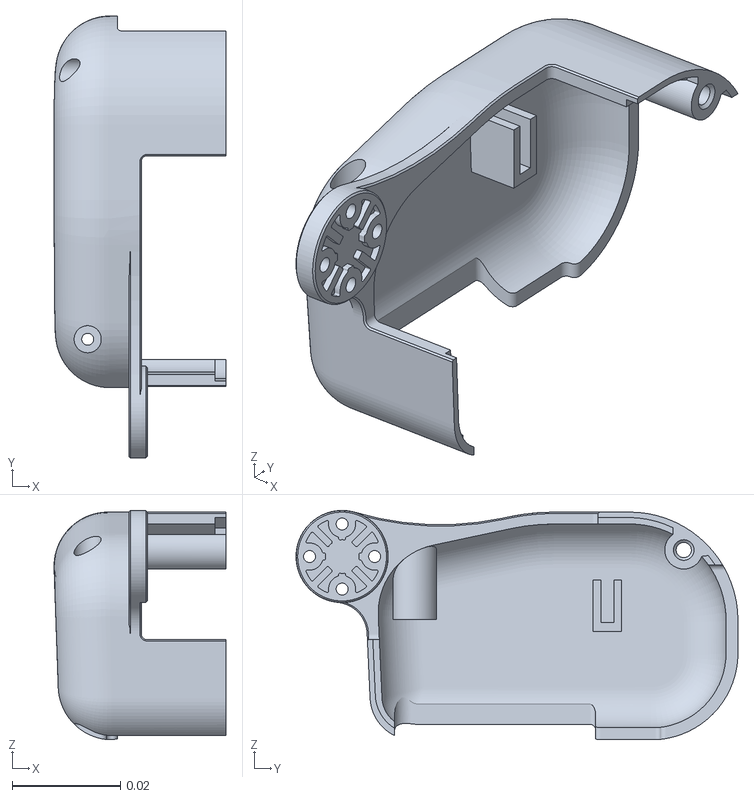
[picture p59: CAD file, 2026-11-09]
training/model/assets/right_shell.stl
0.0317 x 0.0815 x 0.0422
