AleksWolf/kryakva/training/model/rollers/assets/ankle_r_v1.stl

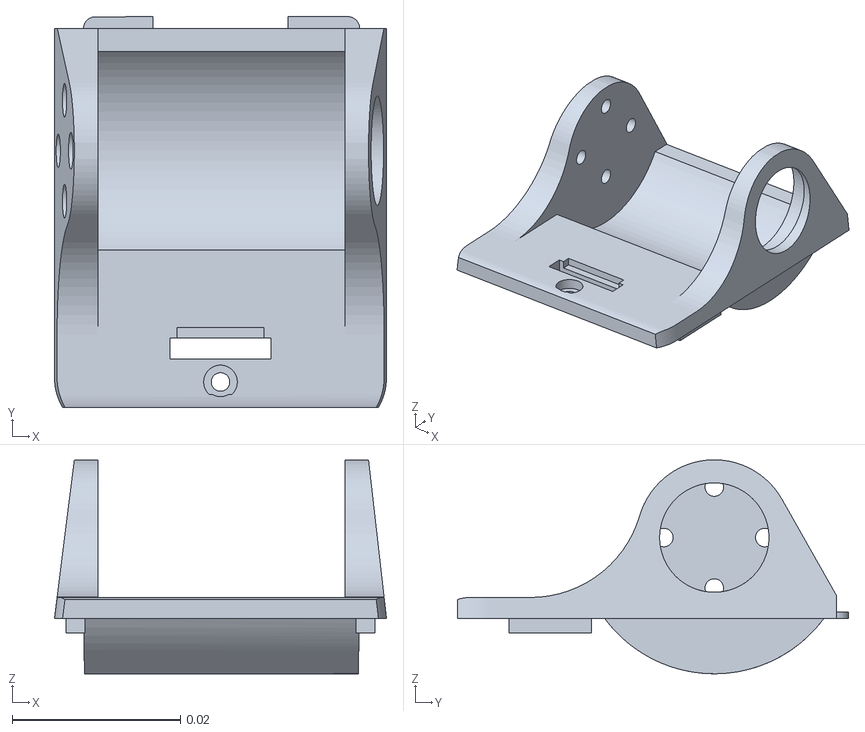
[picture p60: CAD file, 2026-11-09]
training/model/rollers/assets/ankle_r_v1.stl
0.0395 x 0.0465 x 0.0254
