AleksWolf/kryakva/training/model/rollers/assets/roller.stl

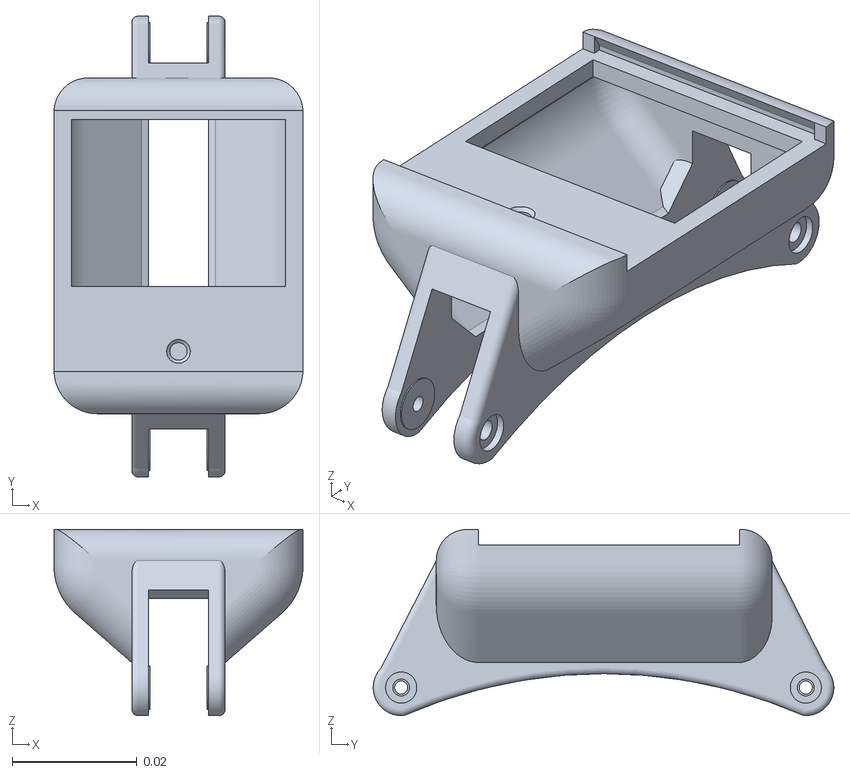
[picture p61: CAD file, 2026-11-09]
training/model/rollers/assets/roller.stl
0.04 x 0.074 x 0.0299
