AleksWolf/kryakva/training/model/assets/power_board_simplified.stl

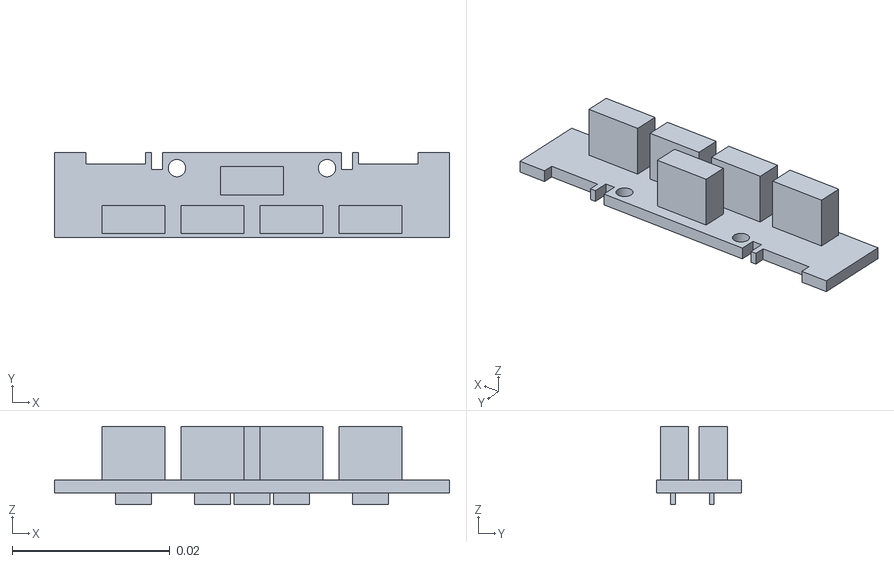
[picture p62: CAD file, 2026-11-09]
training/model/assets/power_board_simplified.stl
0.05 x 0.0108 x 0.0099
