AleksWolf/kryakva/training/model/rollers/assets/tof_vl53l8cx.stl

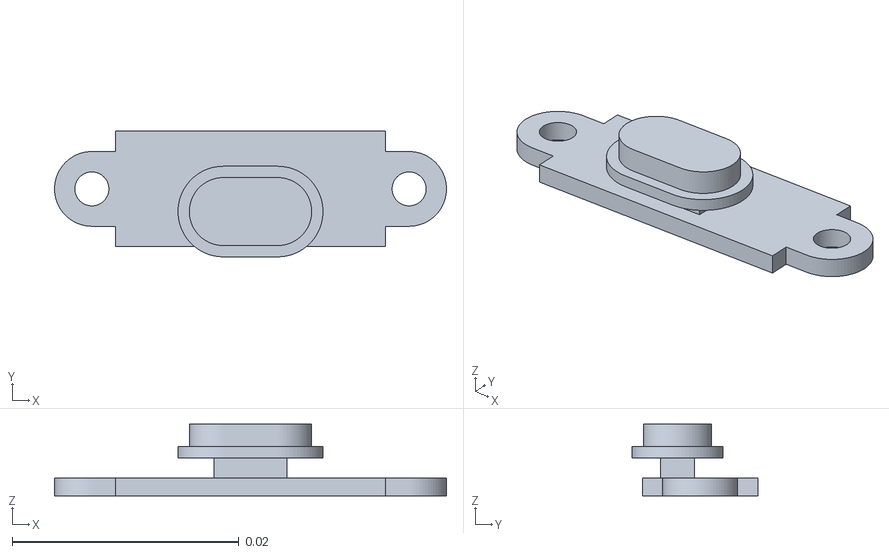
[picture p63: CAD file, 2026-11-09]
training/model/rollers/assets/tof_vl53l8cx.stl
0.0346 x 0.0111 x 0.00635
