AleksWolf/kryakva/training/model/assets/face_part.stl

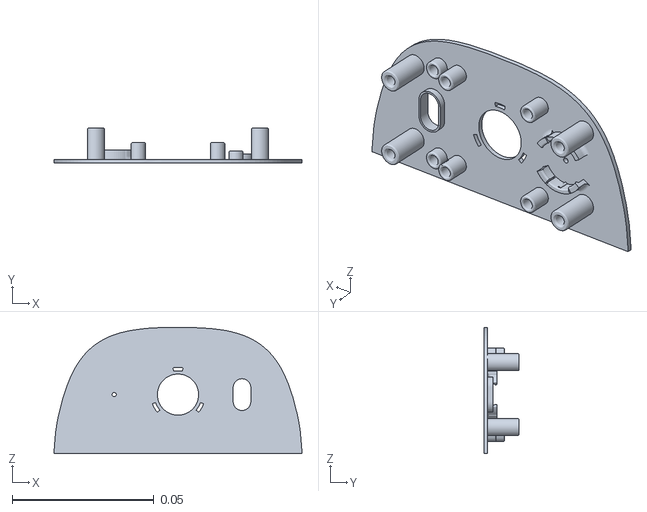
[picture p64: CAD file, 2026-11-09]
training/model/assets/face_part.stl
0.0875 x 0.0125 x 0.0445
