AleksWolf/kryakva/training/model/rollers/assets/top_head_shell.stl

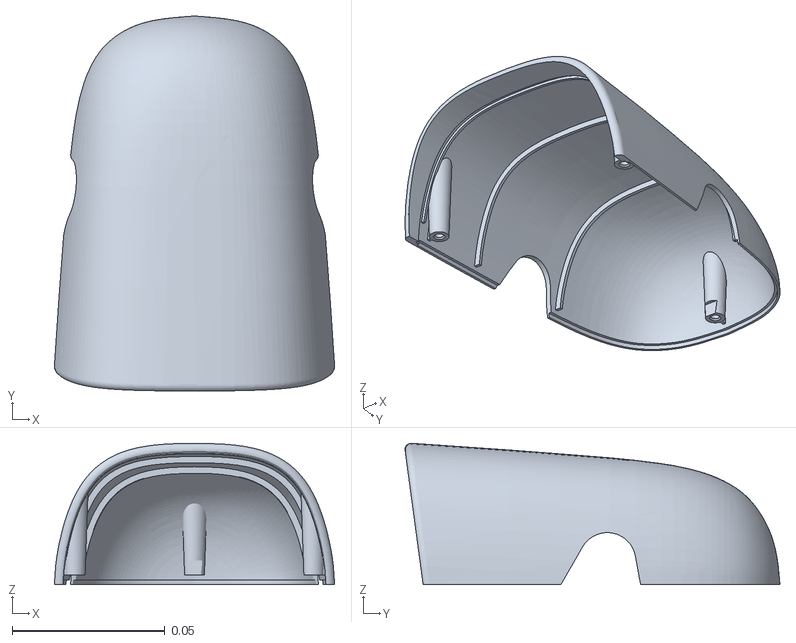
[picture p65: CAD file, 2026-11-09]
training/model/rollers/assets/top_head_shell.stl
0.0917 x 0.123 x 0.0463
