AleksWolf/kryakva/training/model/assets/bearing_15x10x3_simplified.stl

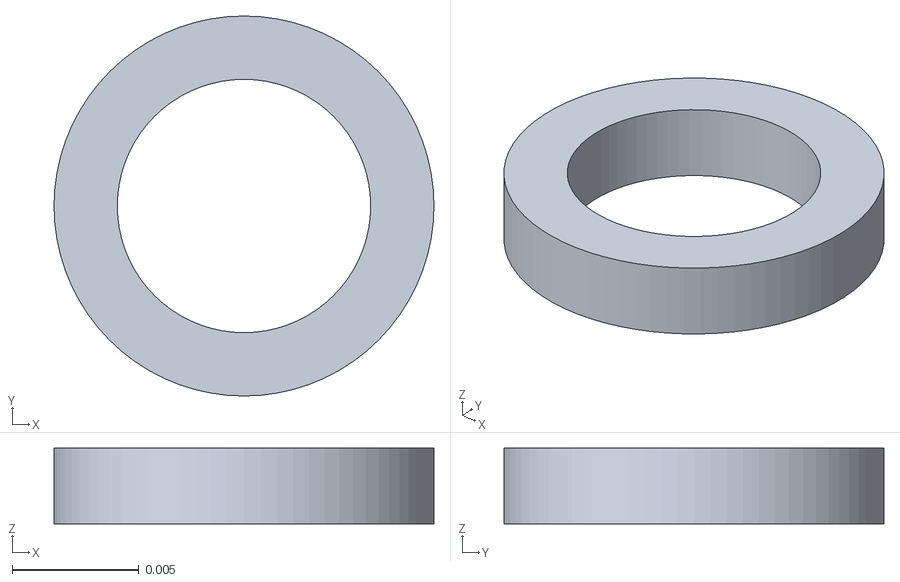
[picture p66: CAD file, 2026-11-09]
training/model/assets/bearing_15x10x3_simplified.stl
0.015 x 0.015 x 0.003
