AleksWolf/kryakva/training/model/assets/jaw_soft.stl

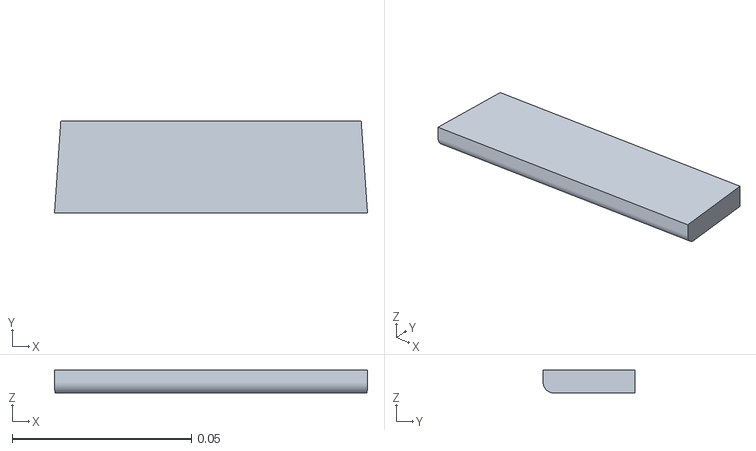
[picture p67: CAD file, 2026-11-09]
training/model/assets/jaw_soft.stl
0.0873 x 0.0256 x 0.0064
