AleksWolf/kryakva/training/model/rollers/assets/yaw_roll_motion.stl

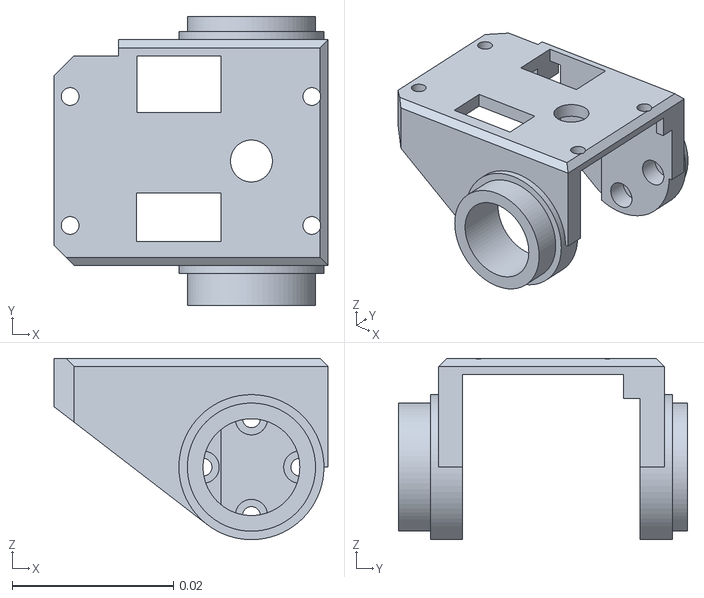
[picture p68: CAD file, 2026-11-09]
training/model/rollers/assets/yaw_roll_motion.stl
0.034 x 0.0359 x 0.0225
