AleksWolf/kryakva/training/model/rollers/assets/roller_blade.stl

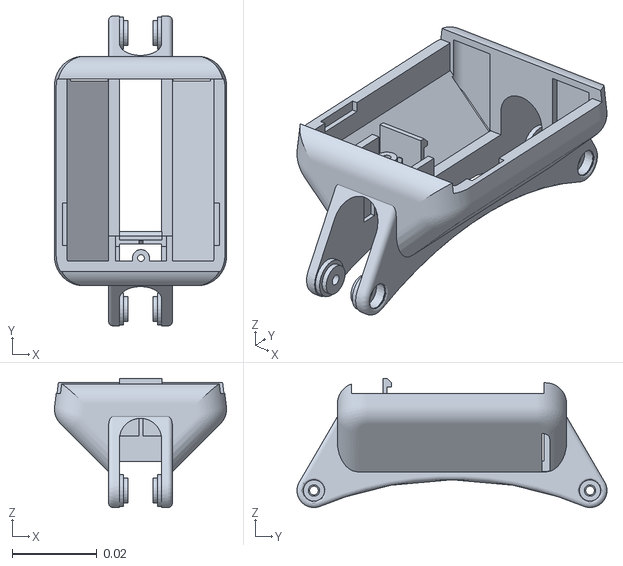
[picture p69: CAD file, 2026-11-09]
training/model/rollers/assets/roller_blade.stl
0.0405 x 0.073 x 0.0304
