AleksWolf/kryakva/training/model/assets/jaw.stl

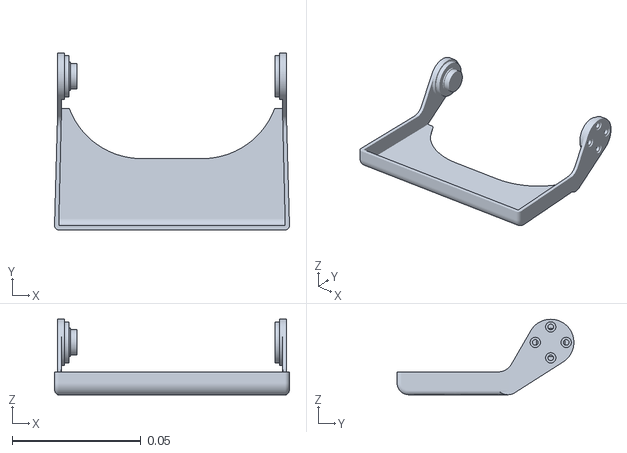
[picture p70: CAD file, 2026-11-09]
training/model/assets/jaw.stl
0.0913 x 0.0687 x 0.0294
