AleksWolf/kryakva/training/model/assets/power_support.stl

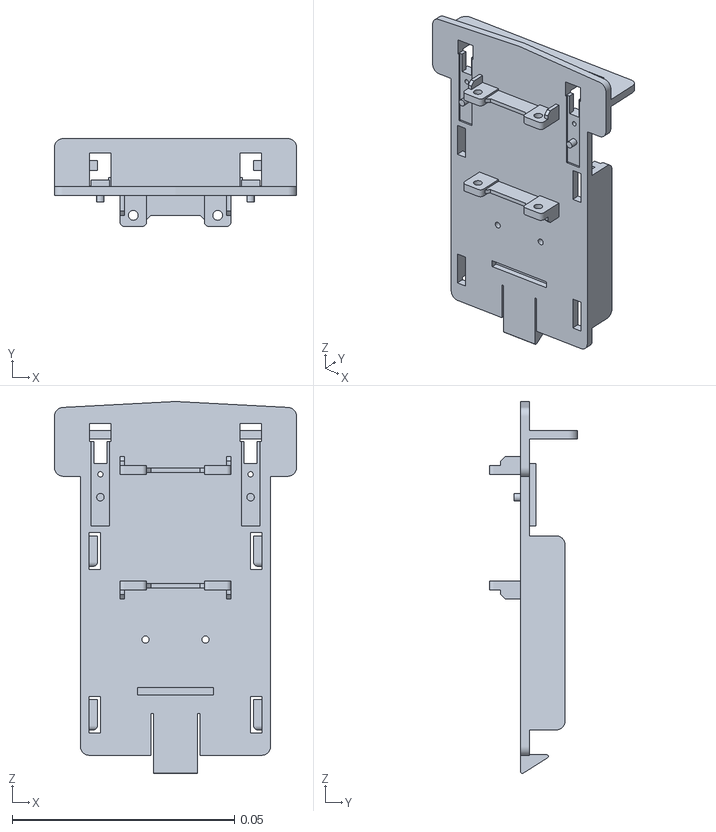
[picture p71: CAD file, 2026-11-09]
training/model/assets/power_support.stl
0.0545 x 0.0198 x 0.0837
