AleksWolf/kryakva/training/model/assets/battery_np_f550.stl

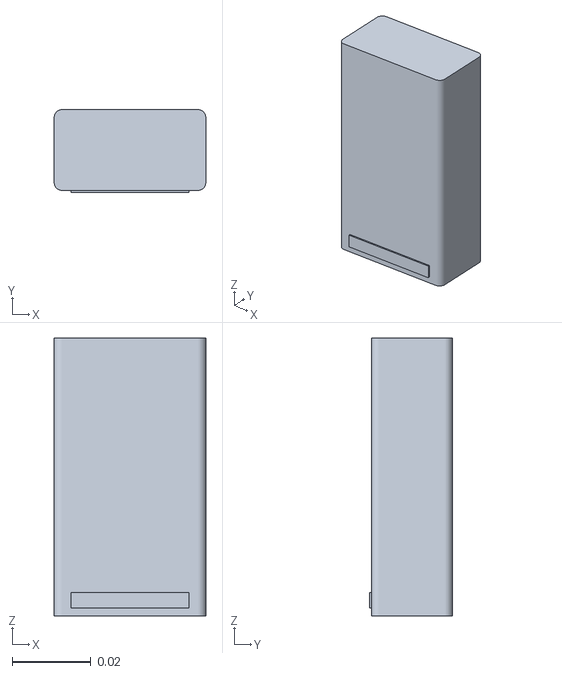
[picture p72: CAD file, 2026-11-09]
training/model/assets/battery_np_f550.stl
0.0386 x 0.0211 x 0.0708
