AleksWolf/kryakva/training/model/assets/hd1910.stl

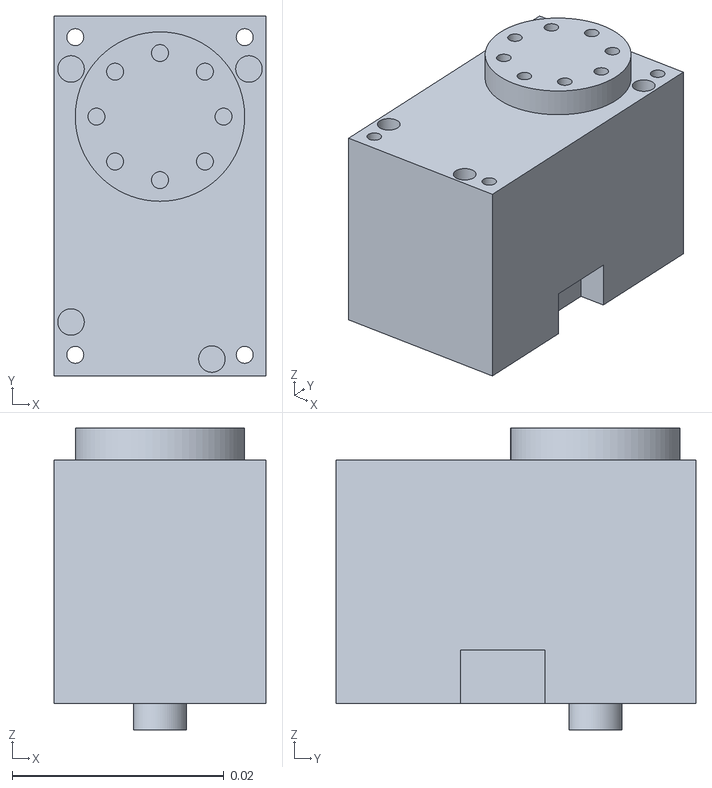
[picture p73: CAD file, 2026-11-09]
training/model/assets/hd1910.stl
0.02 x 0.034 x 0.0285
