AleksWolf/kryakva/training/model/rollers/assets/bearing_12x6x3.stl

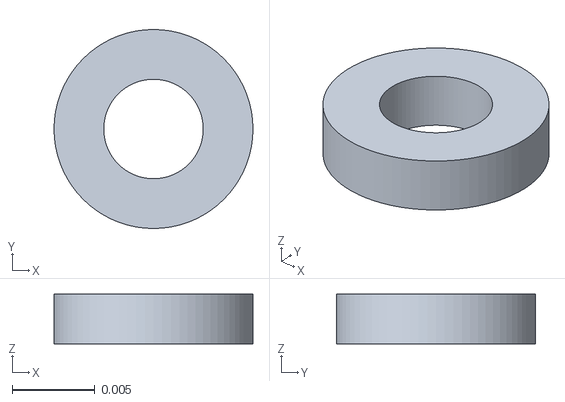
[picture p74: CAD file, 2026-11-09]
training/model/rollers/assets/bearing_12x6x3.stl
0.012 x 0.012 x 0.003
