AleksWolf/kryakva/training/model/assets/rigidity_plate.stl

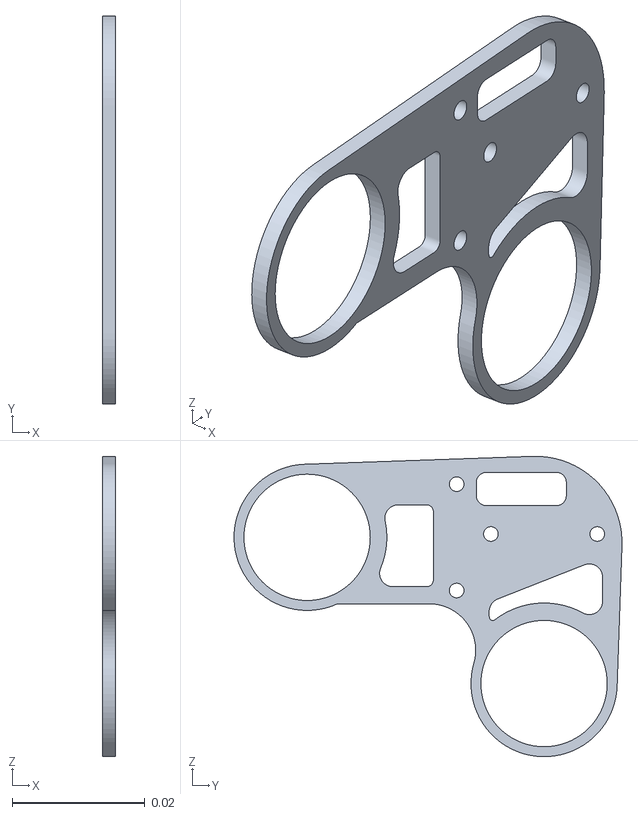
[picture p75: CAD file, 2026-11-09]
training/model/assets/rigidity_plate.stl
0.002 x 0.0584 x 0.0452
