AleksWolf/kryakva/training/model/rollers/assets/bearing_roll.stl

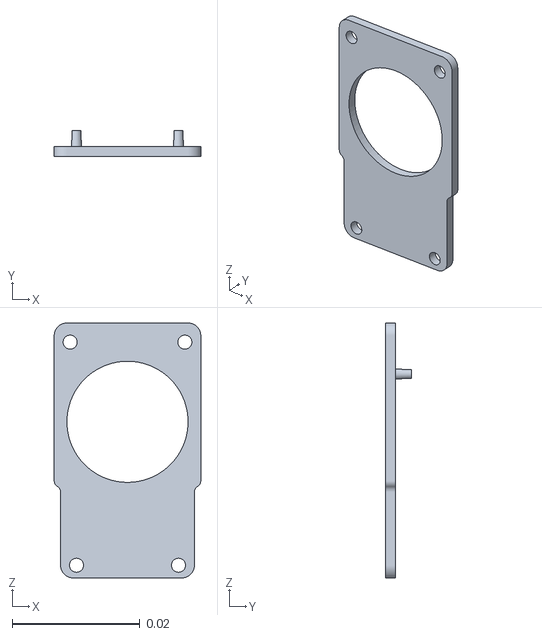
[picture p76: CAD file, 2026-11-09]
training/model/rollers/assets/bearing_roll.stl
0.023 x 0.004 x 0.04
