AleksWolf/kryakva/training/model/assets/bearing_22x16x4.stl

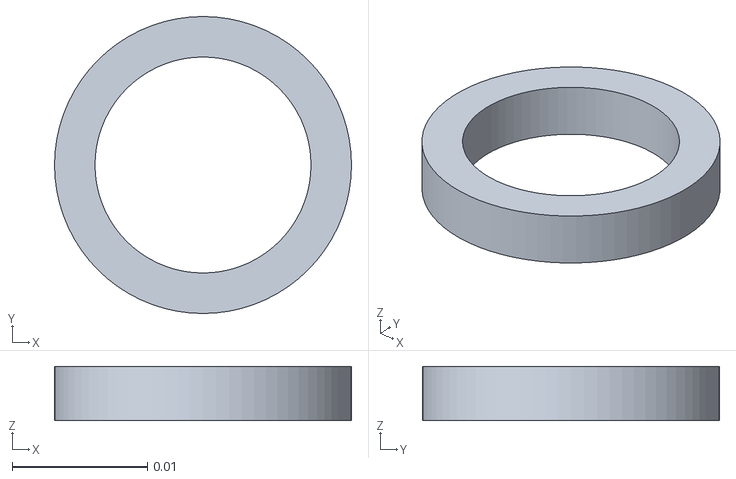
[picture p77: CAD file, 2026-11-09]
training/model/assets/bearing_22x16x4.stl
0.022 x 0.022 x 0.004
