AleksWolf/kryakva/training/model/rollers/assets/radxa_zero_3w.stl

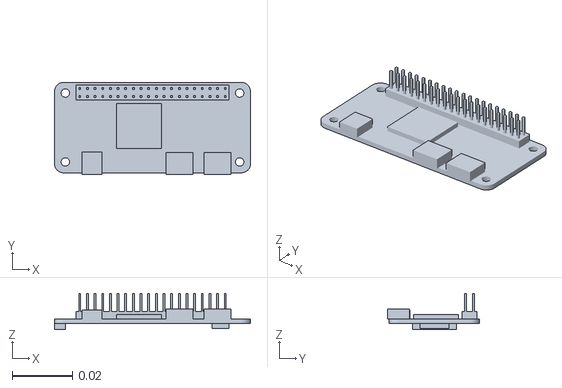
[picture p78: CAD file, 2026-11-09]
training/model/rollers/assets/radxa_zero_3w.stl
0.065 x 0.0306 x 0.0121
