AleksWolf/kryakva/training/model/assets/neck.stl

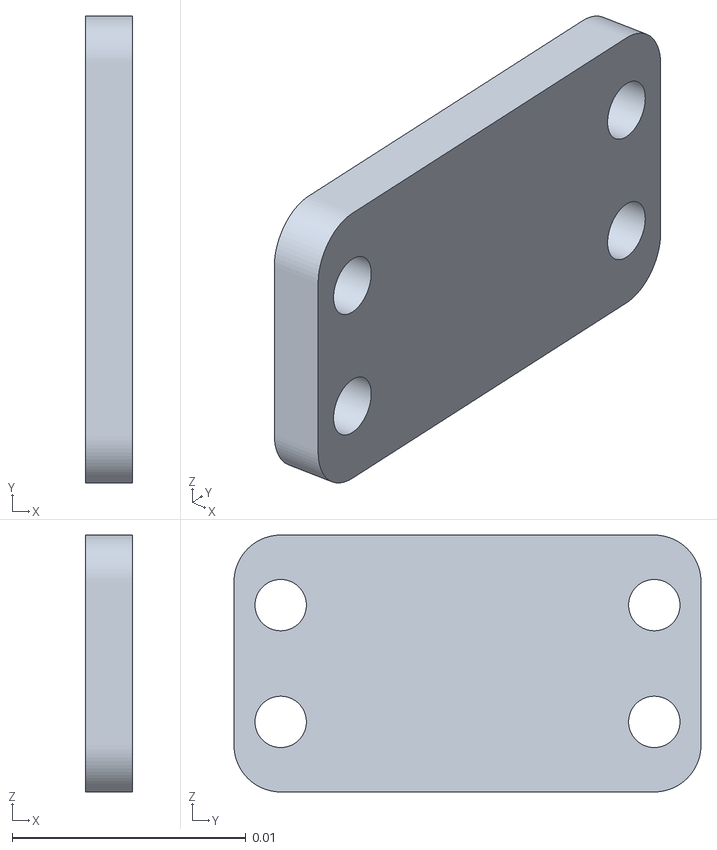
[picture p79: CAD file, 2026-11-09]
training/model/assets/neck.stl
0.002 x 0.02 x 0.011
