AleksWolf/kryakva/training/model/rollers/assets/yaw2roll.stl

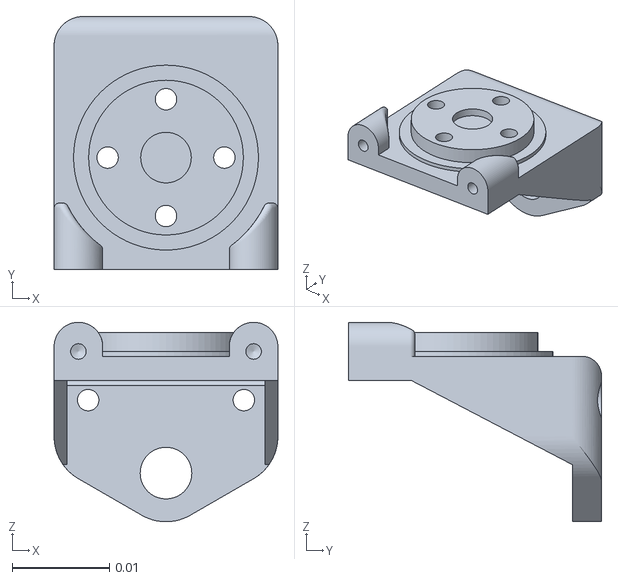
[picture p80: CAD file, 2026-11-09]
training/model/rollers/assets/yaw2roll.stl
0.023 x 0.026 x 0.0205
