AleksWolf/kryakva/training/model/rollers/assets/uc_01.stl

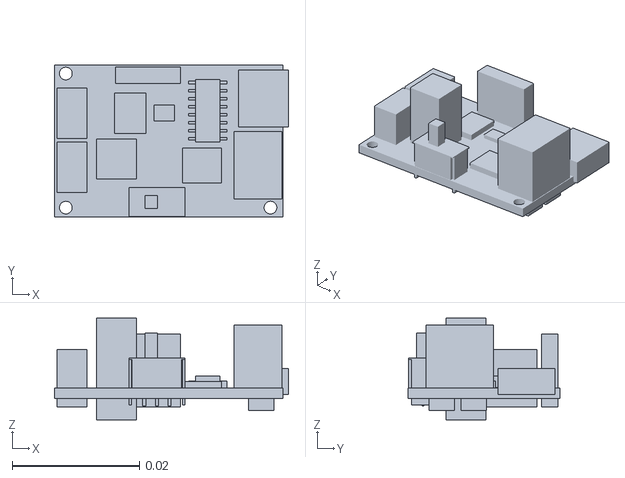
[picture p81: CAD file, 2026-11-09]
training/model/rollers/assets/uc_01.stl
0.0368 x 0.024 x 0.016
