AleksWolf/kryakva/training/model/rollers/assets/soft_mouth_top.stl

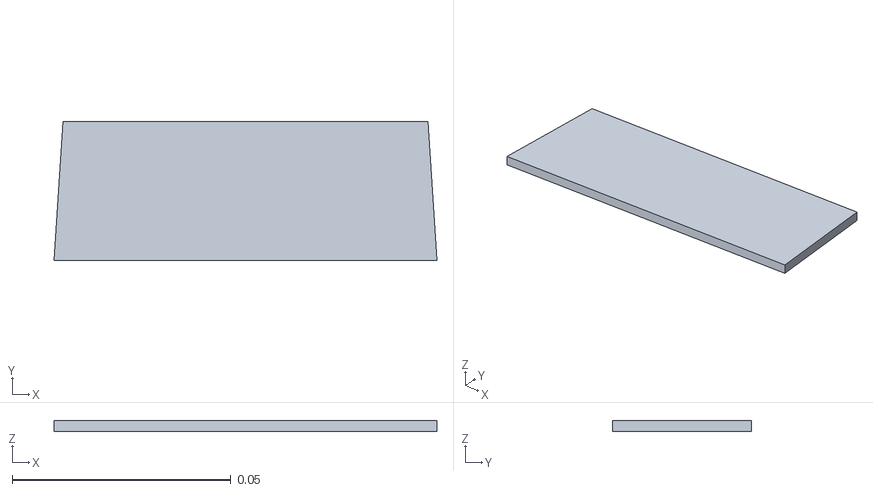
[picture p82: CAD file, 2026-11-09]
training/model/rollers/assets/soft_mouth_top.stl
0.0875 x 0.0317 x 0.0024
