AleksWolf/kryakva/training/model/rollers/assets/upper_leg_right.stl

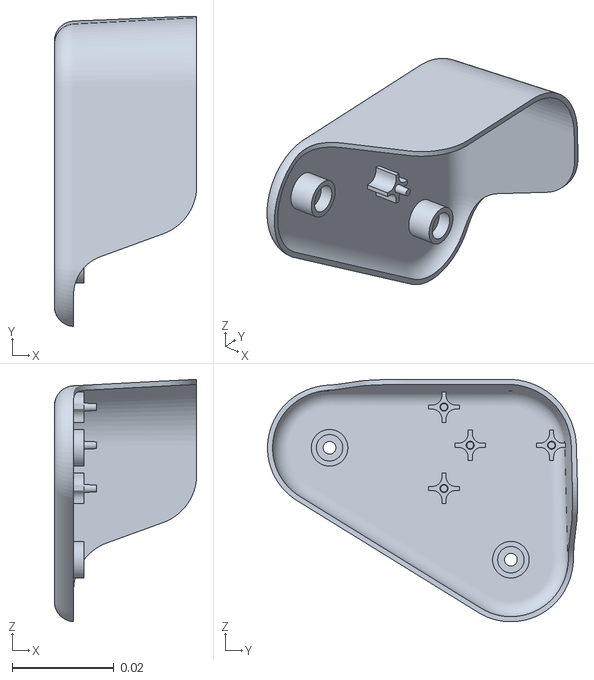
[picture p83: CAD file, 2026-11-09]
training/model/rollers/assets/upper_leg_right.stl
0.028 x 0.0609 x 0.0477
