AleksWolf/kryakva/training/model/rollers/assets/np_f550.stl

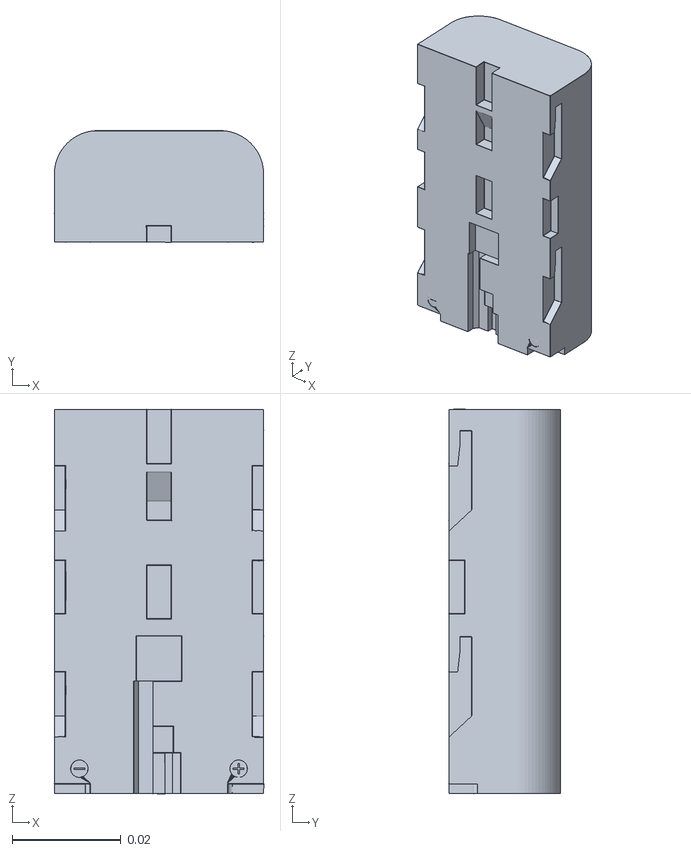
[picture p84: CAD file, 2026-11-09]
training/model/rollers/assets/np_f550.stl
0.0386 x 0.0206 x 0.0708
