AleksWolf/kryakva/training/model/assets/noenoeil.stl

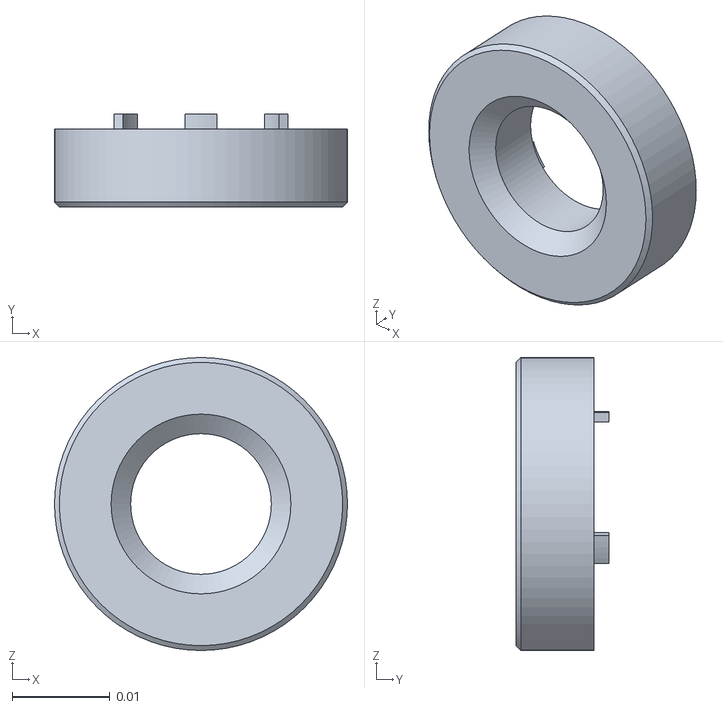
[picture p85: CAD file, 2026-11-09]
training/model/assets/noenoeil.stl
0.03 x 0.0095 x 0.03
