AleksWolf/kryakva/training/model/rollers/assets/bearing_neck.stl

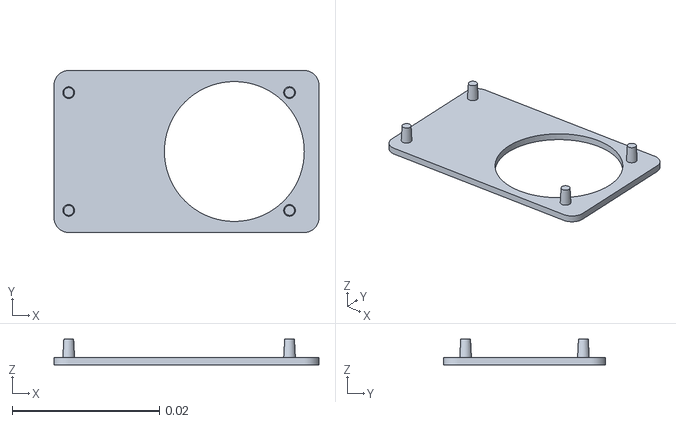
[picture p86: CAD file, 2026-11-09]
training/model/rollers/assets/bearing_neck.stl
0.036 x 0.022 x 0.0035
