AleksWolf/kryakva/training/model/assets/bottom_head_shell.stl

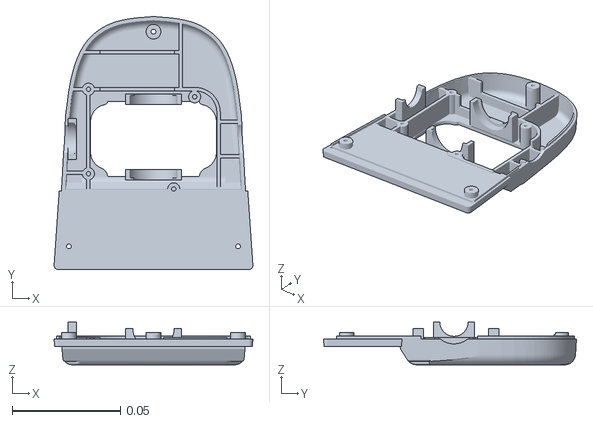
[picture p87: CAD file, 2026-11-09]
training/model/assets/bottom_head_shell.stl
0.0917 x 0.117 x 0.0197
