AleksWolf/kryakva/training/model/rollers/assets/leg.stl

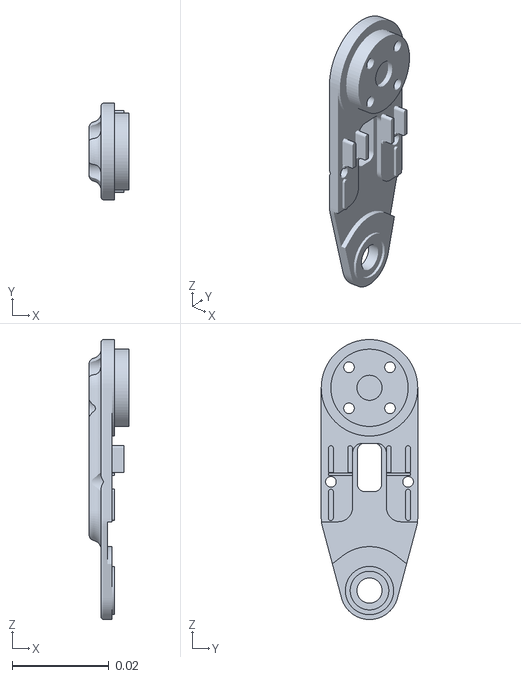
[picture p88: CAD file, 2026-11-09]
training/model/rollers/assets/leg.stl
0.00825 x 0.02 x 0.058
