AleksWolf/kryakva/training/model/rollers/assets/camera_8m_219_simplified.stl

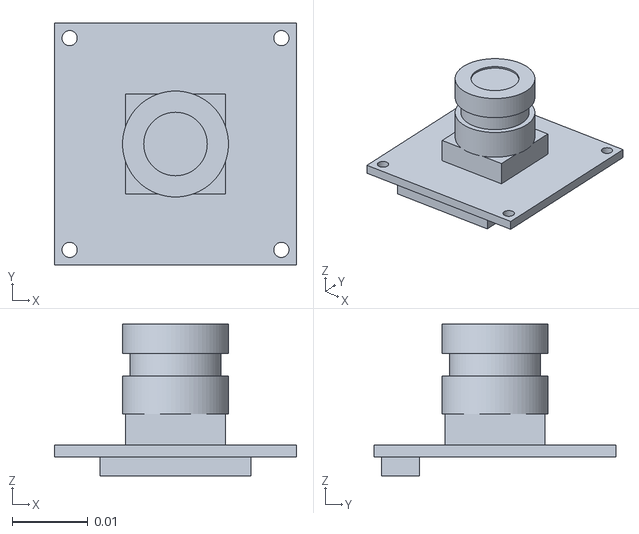
[picture p89: CAD file, 2026-11-09]
training/model/rollers/assets/camera_8m_219_simplified.stl
0.032 x 0.032 x 0.0201
