AleksWolf/kryakva/training/model/assets/banana_pcb_locker.stl

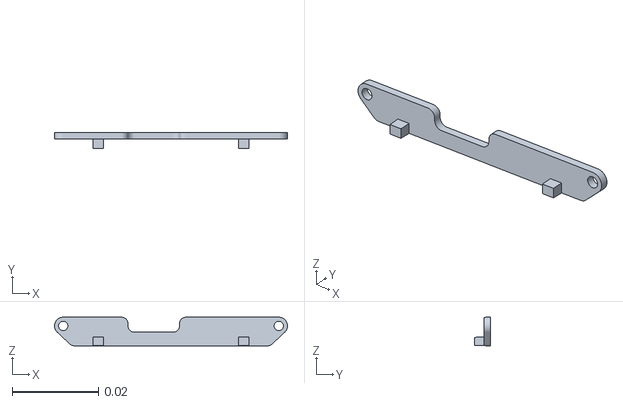
[picture p90: CAD file, 2026-11-09]
training/model/assets/banana_pcb_locker.stl
0.0541 x 0.0038 x 0.00665
