AleksWolf/kryakva/training/model/assets/imu_lsm6dsv16x.stl

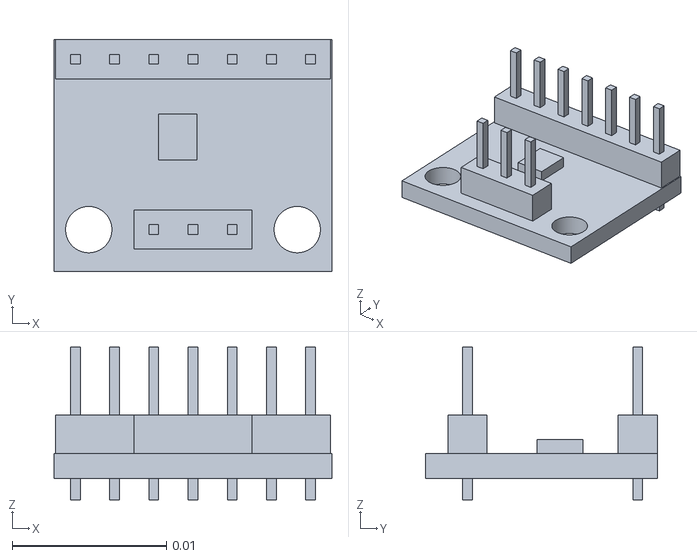
[picture p91: CAD file, 2026-11-09]
training/model/assets/imu_lsm6dsv16x.stl
0.018 x 0.015 x 0.0099
