AleksWolf/kryakva/training/model/rollers/assets/motor_support.stl

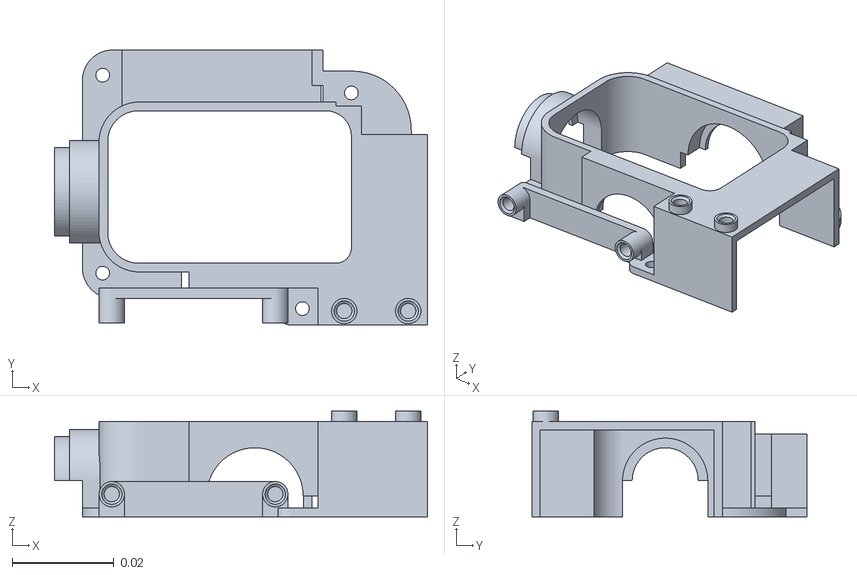
[picture p92: CAD file, 2026-11-09]
training/model/rollers/assets/motor_support.stl
0.0735 x 0.0542 x 0.0208
