AleksWolf/kryakva/training/model/assets/mic_ics43434_round_simplified.stl

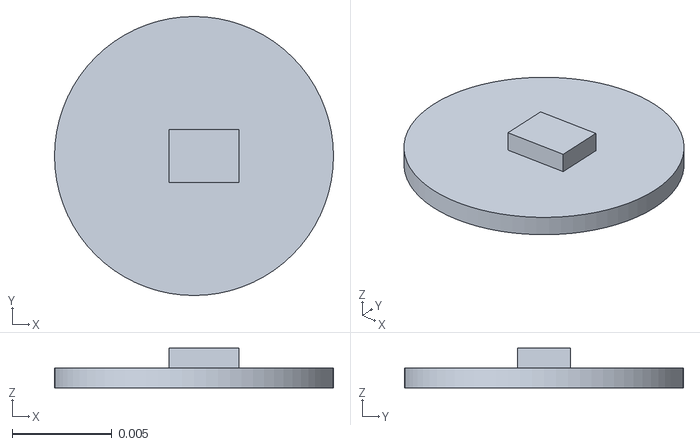
[picture p93: CAD file, 2026-11-09]
training/model/assets/mic_ics43434_round_simplified.stl
0.014 x 0.014 x 0.002
