AleksWolf/kryakva/training/model/rollers/assets/rim.stl

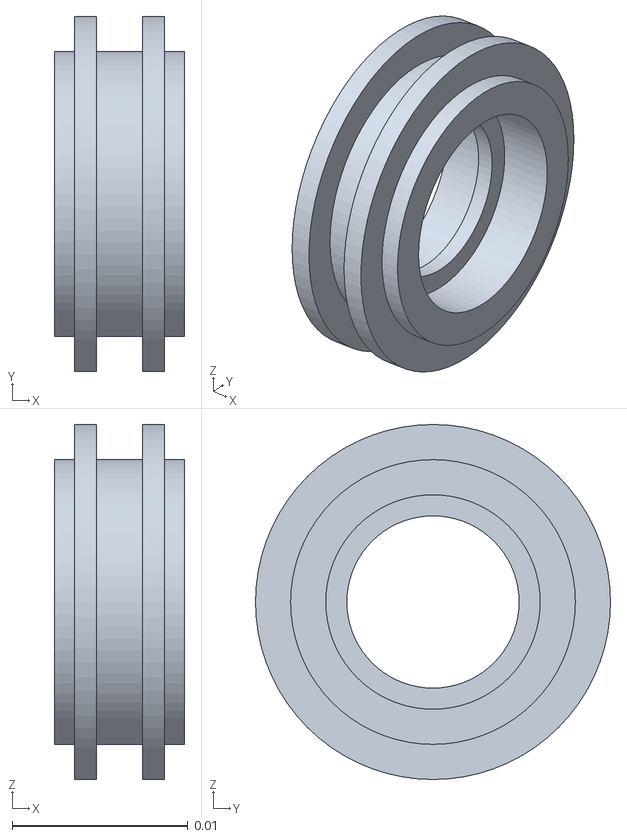
[picture p94: CAD file, 2026-11-09]
training/model/rollers/assets/rim.stl
0.0074 x 0.0202 x 0.0202
