AleksWolf/kryakva/training/model/assets/sole_right.stl

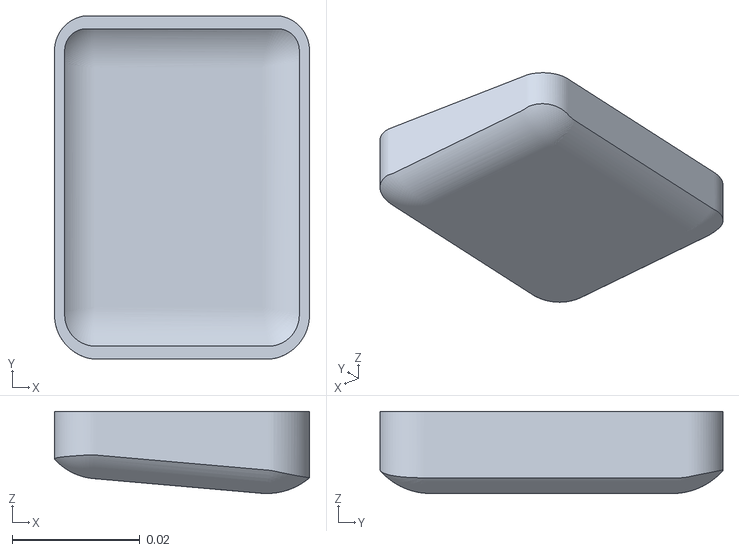
[picture p95: CAD file, 2026-11-09]
training/model/assets/sole_right.stl
0.04 x 0.0538 x 0.0129
