AleksWolf/kryakva/training/model/rollers/assets/bearing_12x6x4_simplified.stl

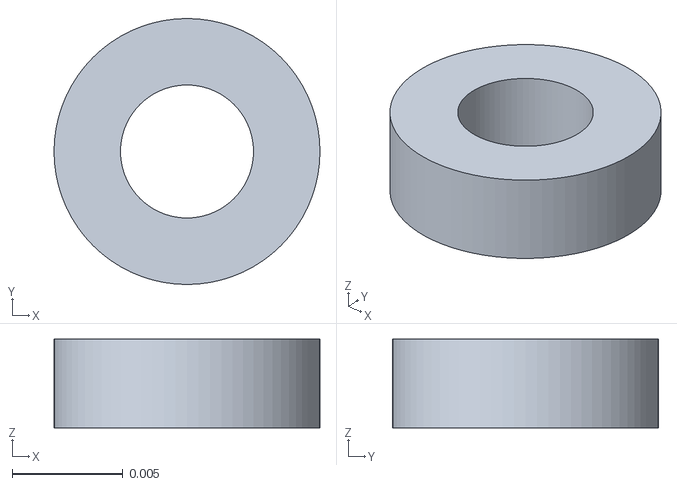
[picture p96: CAD file, 2026-11-09]
training/model/rollers/assets/bearing_12x6x4_simplified.stl
0.012 x 0.012 x 0.004
