AleksWolf/kryakva/training/model/rollers/assets/imu_lsm6dsv16x_module_simplified.stl

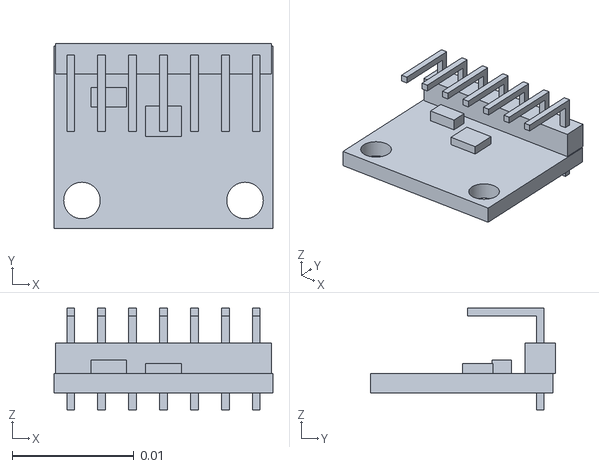
[picture p97: CAD file, 2026-11-09]
training/model/rollers/assets/imu_lsm6dsv16x_module_simplified.stl
0.018 x 0.0152 x 0.00836
