AleksWolf/kryakva/training/model/assets/foot_right.stl

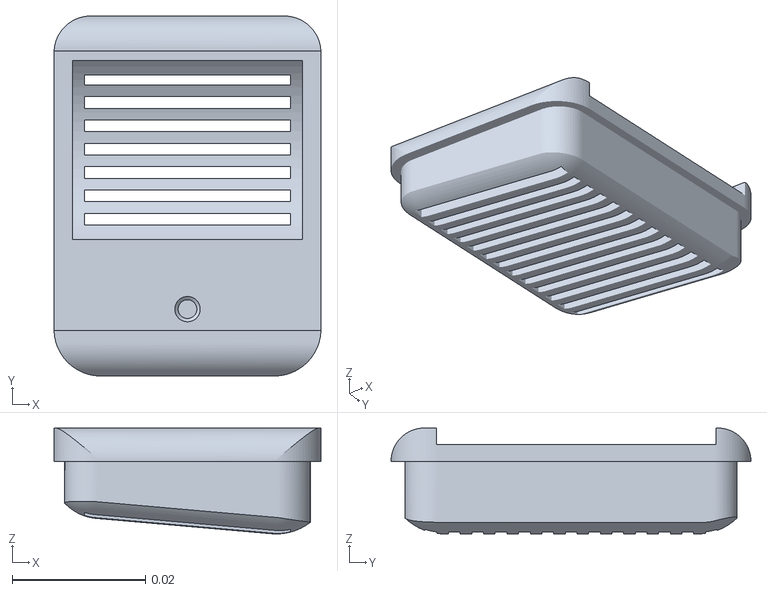
[picture p98: CAD file, 2026-11-09]
training/model/assets/foot_right.stl
0.04 x 0.054 x 0.0159
