AleksWolf/kryakva/training/model/assets/left_shell.stl

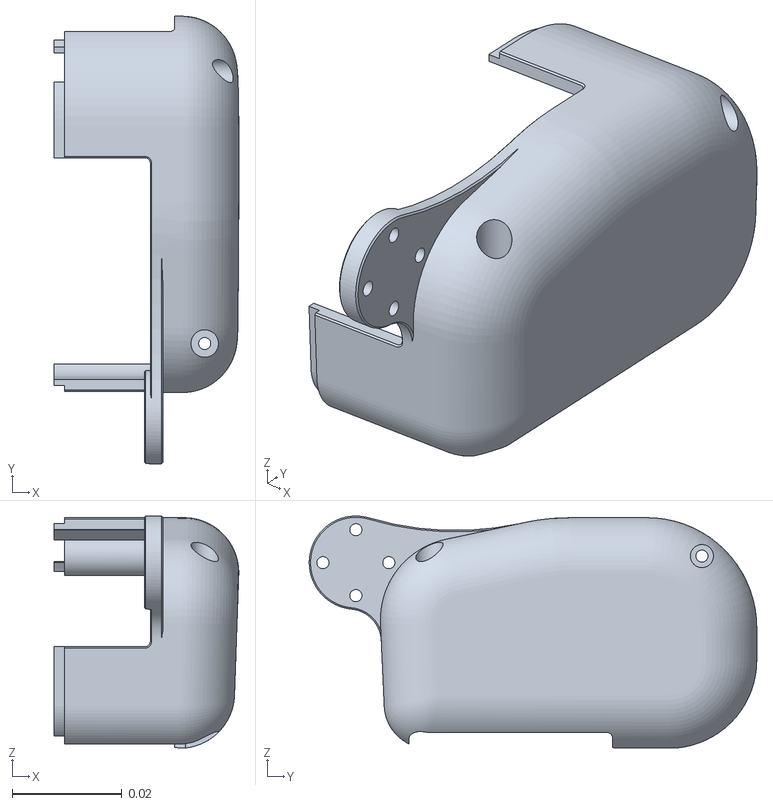
[picture p99: CAD file, 2026-11-09]
training/model/assets/left_shell.stl
0.0336 x 0.0815 x 0.0422
