AleksWolf/kryakva/training/model/rollers/assets/ankle_axle.stl

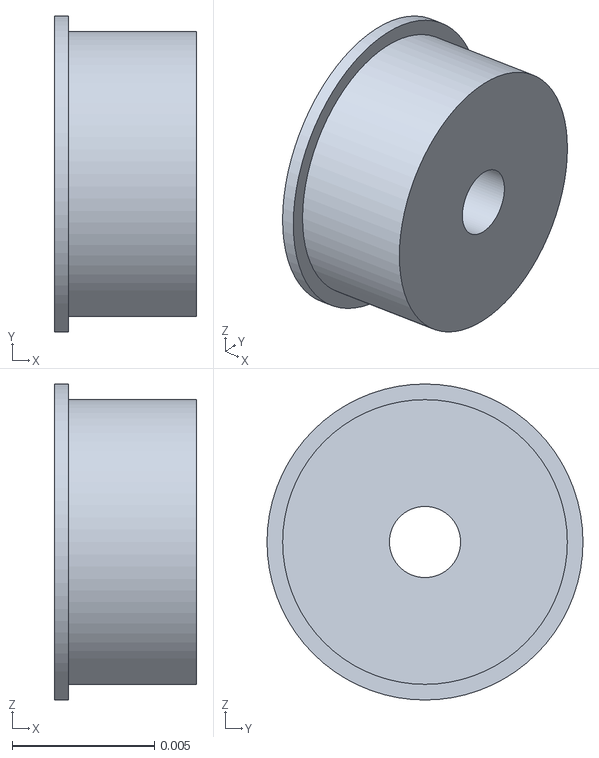
[picture p100: CAD file, 2026-11-09]
training/model/rollers/assets/ankle_axle.stl
0.005 x 0.0111 x 0.0111
