AleksWolf/kryakva/training/model/rollers/assets/trunk_base.stl

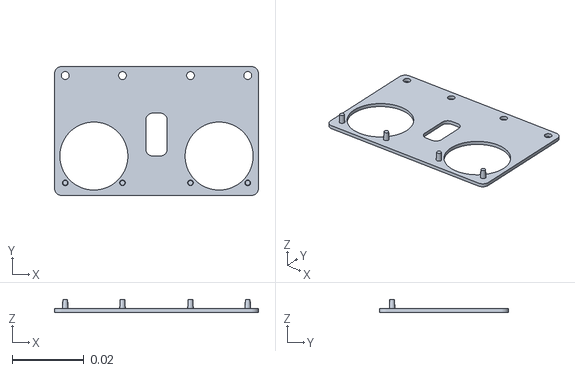
[picture p101: CAD file, 2026-11-09]
training/model/rollers/assets/trunk_base.stl
0.057 x 0.036 x 0.0035
