AleksWolf/kryakva/training/model/rollers/assets/bushing.stl

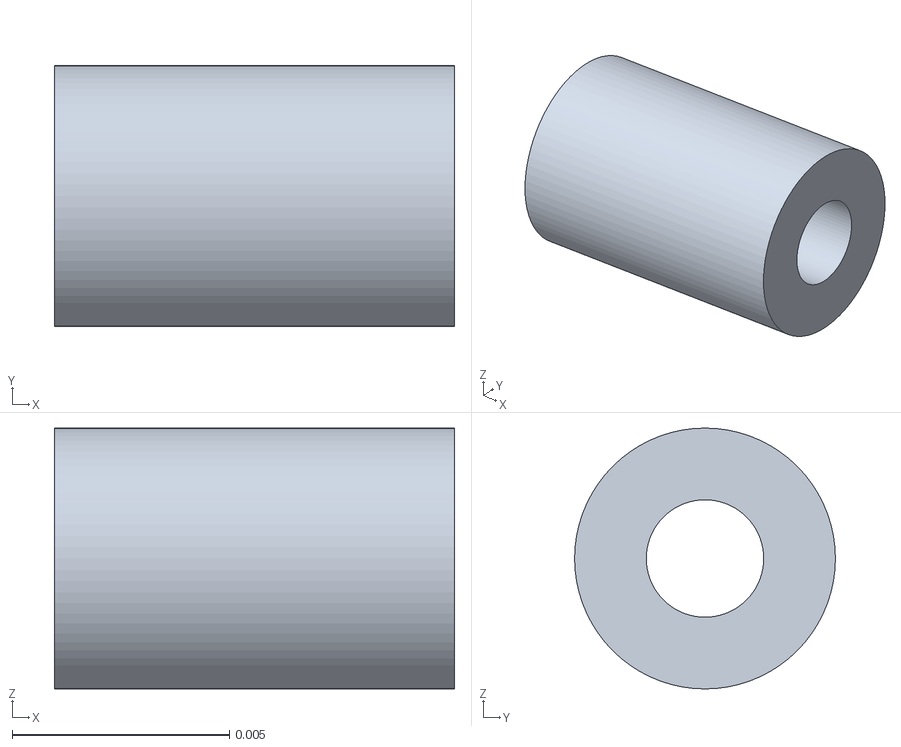
[picture p102: CAD file, 2026-11-09]
training/model/rollers/assets/bushing.stl
0.0092 x 0.006 x 0.006
