AleksWolf/kryakva/(list of files, cad)

Other CAD files:
training/model/rollers/assets/ankle_left.stl
training/model/assets/tof_vl53l8cx_board_simplified.stl
training/model/assets/bearing_22x16x4_simplified.stl
training/model/rollers/assets/ankle_l_v1.stl
training/model/assets/hd1910_servo_simplified.stl
training/model/assets/upper_leg_rigidity_plate.stl
training/model/assets/hip.stl
training/model/assets/radxa_zero_3w_simplified.stl
training/model/rollers/assets/speaker_2535_simplified.stl
training/model/assets/upper_leg_left.stl
training/model/assets/ankle_left.stl
training/model/rollers/assets/tof_vl53l8cx_board_simplified.stl
training/model/assets/sole_left.stl
training/model/rollers/assets/bearing_15x10x3.stl
training/model/assets/camera_8m_219.stl
training/model/assets/top_head_shell.stl
training/model/rollers/assets/mic_ics43434.stl
training/model/rollers/assets/bottom_head_shell.stl
training/model/assets/speaker_2535_simplified.stl
training/model/rollers/assets/upper_leg_rigidity_plate.stl
training/model/assets/mic_ics43434.stl
training/model/rollers/assets/upper_leg_left.stl
training/model/rollers/assets/bearing_22x16x4_simplified.stl
training/model/assets/uc01_simple.stl
training/model/assets/foot_left.stl
training/model/rollers/assets/uc01_simple.stl
training/model/assets/bearing_15x10x3.stl
training/model/rollers/assets/camera_8m_219.stl
training/model/rollers/assets/radxa_zero_3w_simplified.stl
training/model/rollers/assets/hip.stl
training/model/rollers/assets/hd1910_servo_simplified.stl
training/model/assets/max98357a.stl
training/model/assets/max98357a_module_simplified.stl
training/model/rollers/assets/max98357a.stl
training/model/rollers/assets/max98357a_module_simplified.stl
