AleksWolf/kryakva/hardware/wiring.ru.md

# Подключение электроники

Вся электроника, кроме IMU и PCB, стоит в голове и сходится на 40-контактной гребёнке Radxa Zero 3W.
Схема — [wiring.ru.png](wiring.ru.png), вид на гребёнку со стороны штырей. Цвета на схеме — цвета проводов.

## Гребёнка Zero 3W

| Пин | Куда | Цвет провода |
|---|---|---|
| 1 | IMU 3.3 В | красный |
| 2 | усилитель VIN (5 В) | красный |
| 3 | IMU SDA | синий |
| 4 | UBEC +5 (питание Zero) | красный |
| 5 | IMU SCL | зелёный |
| 6 | UBEC − | чёрный |
| 8 | UC-01 R | жёлтый |
| 10 | UC-01 T | белый |
| 12 | усилитель BCLK (и SCK микрофона) | фиолетовый |
| 13 | усилитель SD (включение) | серый |
| 14 | общая земля | чёрный |
| 17 | ToF VIN (3.3 В) и VDD микрофона | красный |
| 29 | ToF SCL | зелёный |
| 31 | ToF SDA | синий |
| 35 | усилитель LRC (и WS микрофона) | оранжевый |
| 38 | микрофон SD | серый |
| 40 | усилитель DIN | коричневый |

Красные провода на пины 2 и 4 — 5 В, на пины 1 и 17 — 3.3 В. На ToF подавать только 3.3 В.

## Земля

Земли UC-01, ToF, IMU, микрофона и усилителя соединены вместе и одним проводом идут на пин 14.

## Модули

- **UC-01** (шина серв). Переключатель уровня — 3.3 В. Провода R, T, G — Dupont, к колодке UC-01 и к гребёнке Zero.
  Порт 1 — цепочка серв головы. Порт 2 — питание от PCB (кабель № 12 из [cables.md](cables.ru.md)). Пока UC-01 работает с Zero, USB-C свободен.
- **UBEC 5 В / 3 А** (питание Zero). Вход IN+ и IN− — в винтовой клеммник питания UC-01 (6–15 В). Выход: +5 → пин 4, − → пин 6.
- **IMU LSM6DSV16X** — в туловище, на `power_support`; провода идут через шею. Перемычки на модуле: AD0 → GND, CS → VCC.
  Цвета: VCC красный, GND чёрный, SDA синий, SCL зелёный.
- **ToF VL53L8CX**. Перемычки обязательны: SPI_I2C_N и NCS — между собой и на GND. С ними модуль проверен на утке. MISO, INT, LPn свободны.
- **Микрофон I²S**. Перемычка L/R → GND (левый канал). SCK и WS припаяны к BCLK и LRC усилителя с обратной стороны его платы; VDD — к VIN модуля ToF.
- **Усилитель MAX98357A**. Провода динамика припаяны к плате усилителя. GAIN свободен. SD — на пин 13: служба `duck-amp` включает усилитель только на время звука ([software/zero_setup.md](../software/zero_setup.ru.md)).
- **Камера** — шлейфом в разъём камеры Zero, мимо гребёнки.

## Ориентация датчиков

Со стороны утки: кадр ToF 8×8 повёрнут на 270° по часовой стрелке, кадр камеры — на 90° по часовой, без отражений.
IMU: ось X датчика смотрит влево, Y — вверх, Z — вперёд.

## Пайка

- **PCB.** 5 вилок AMP 2.0-3P — открытой частью к переду утки. К площадкам BAT− и BAT+ — провода 16 (18) AWG от контактов батареи
  на power_support. Кабель с одной вилкой: провода питания и земли — к площадкам питания шеи.
- **UC-01.** Выпаять заводские разъёмы серв и прямую гребёнку; впаять угловую гребёнку и две вилки AMP 2.0-3P.

## Питание серв

Батарея NP-F550 → PCB ([power_board/README.md](power_board/README.ru.md)) → две цепочки ног и, через кабель № 13, цепочка головы.
