AleksWolf/kryakva/docs/assembly/index.ru.html

# Сборка Microduck

Пошаговая сборка утки на сервах HD-1910.

Загружаю модель…

ставим сейчасуже собрано

ПовторитьВписатьОкружение

← НазадДальше →

### Шаги фазы

## Крепёж на всю утку

Сумма по шагам; шаги ног и роликов посчитаны на две стороны. Цвет — как у винтов на 3D-сцене.

## Подшипники и покупное

## Сервы: ID и место

Середина 2048 — качалка выровнена по калибровочной пластине (hardware/servo_setup.md).

## Кабели шины

9 кабелей 15 см — из коробок серв, остальные — по списку закупки (hardware/cables.md).

## Печатные детали в сборке
