AleksWolf/kryakva/print/README.ru.md

# Профили печати

Три проекта Bambu Studio. Детали расставлены по столам и повёрнуты для печати, количества — на одну утку.

## Какой профиль выбрать

- **Принтер с двумя соплами или механической сменой сопла** — [microduck-x2d-0.4.3mf](microduck-x2d-0.4.3mf) и [microduck-x2d-0.6.3mf](microduck-x2d-0.6.3mf)
  (сделаны для Bambu Lab X2D). Нужны оба проекта: в 0.4 — жёсткие детали, в 0.6 — мягкие детали и колёса роликов.
- **Остальные принтеры** — [microduck-p2s-0.4.3mf](microduck-p2s-0.4.3mf) (сделан для Bambu Lab P2S, одно сопло 0.4). В нём все детали утки.

## Что в проектах

| Файл | Сопло | Детали | Материалы |
|---|---|---|---|
| [microduck-x2d-0.4.3mf](microduck-x2d-0.4.3mf) | 0.4 | все жёсткие детали, 40 шт., 6 столов | PLA Basic; `zero clamp` — ASA-CF; контактный слой поддержек — PETG Basic |
| [microduck-x2d-0.6.3mf](microduck-x2d-0.6.3mf) | 0.6 | подошвы, `jaw_soft`, `soft_mouth_top`, 4 колеса роликов (обод и шина печатаются одной деталью), 8 шт., 3 стола | TPU 85A (сопло 0.6); обод колеса и поддержки — PLA Basic |
| [microduck-p2s-0.4.3mf](microduck-p2s-0.4.3mf) | 0.4 | все детали, 52 шт., 6 столов; обод и шина колеса — отдельными деталями, шину натянуть на обод | PLA Basic; `zero clamp` — ASA; мягкие детали и шины — TPU 90A (сопло 0.4) |

Слой 0.2 мм на сопле 0.4 и 0.3 мм на сопле 0.6. Поддержки включены у деталей, которым они нужны. Стол — Textured PEI.

Для другого принтера детали и их ориентация — из этих проектов, настройки — по таблице.
