AleksWolf/kryakva/docs/assembly/img/wiring.png

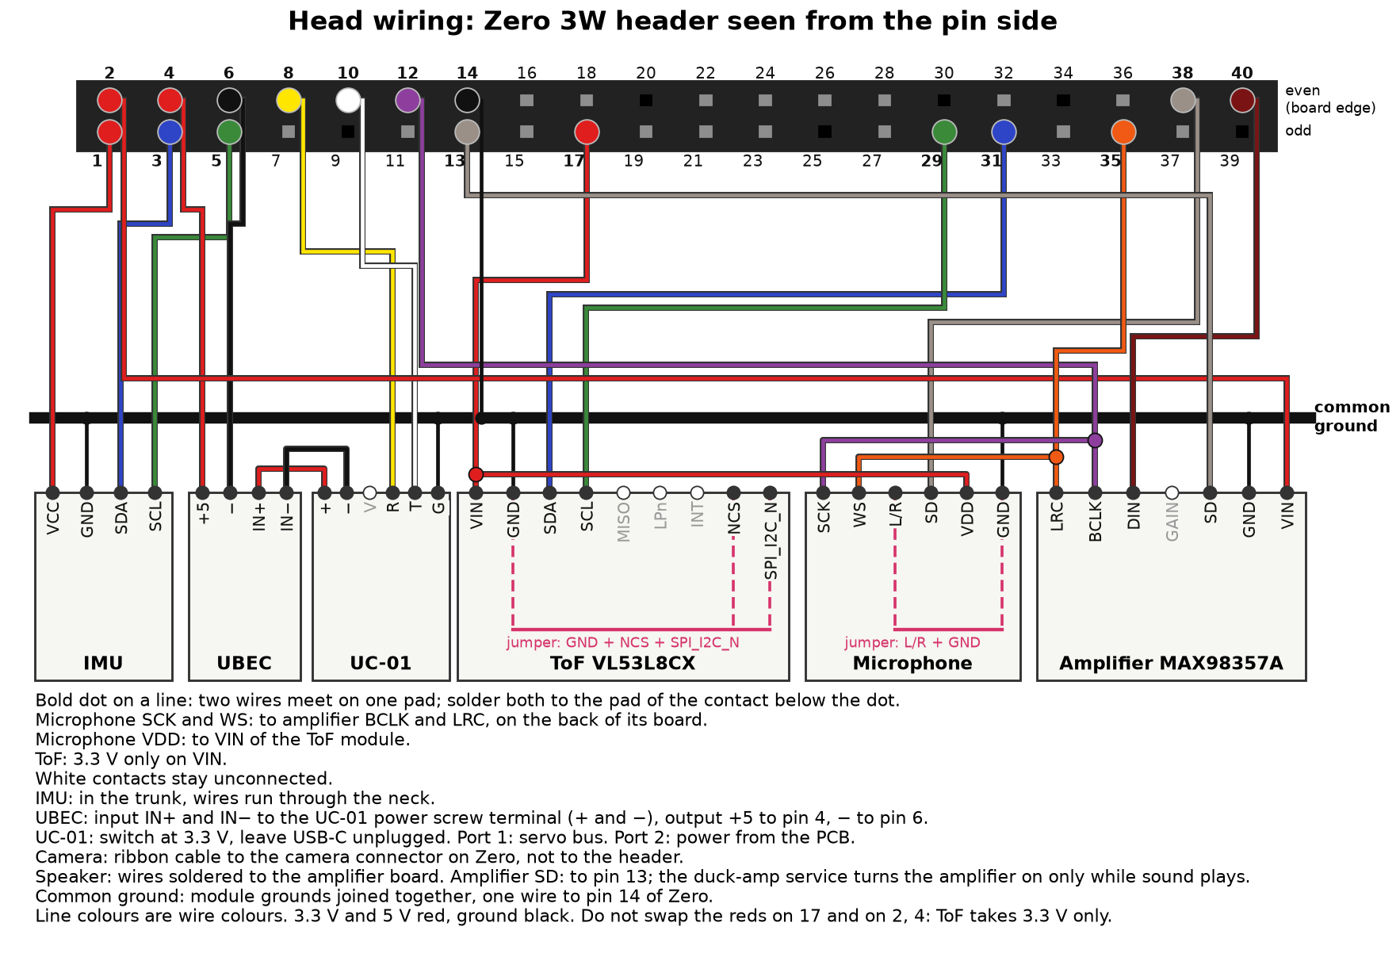
docs/assembly/img/wiring.png
