AleksWolf/kryakva/docs/assembly/img/wiring.ru.png

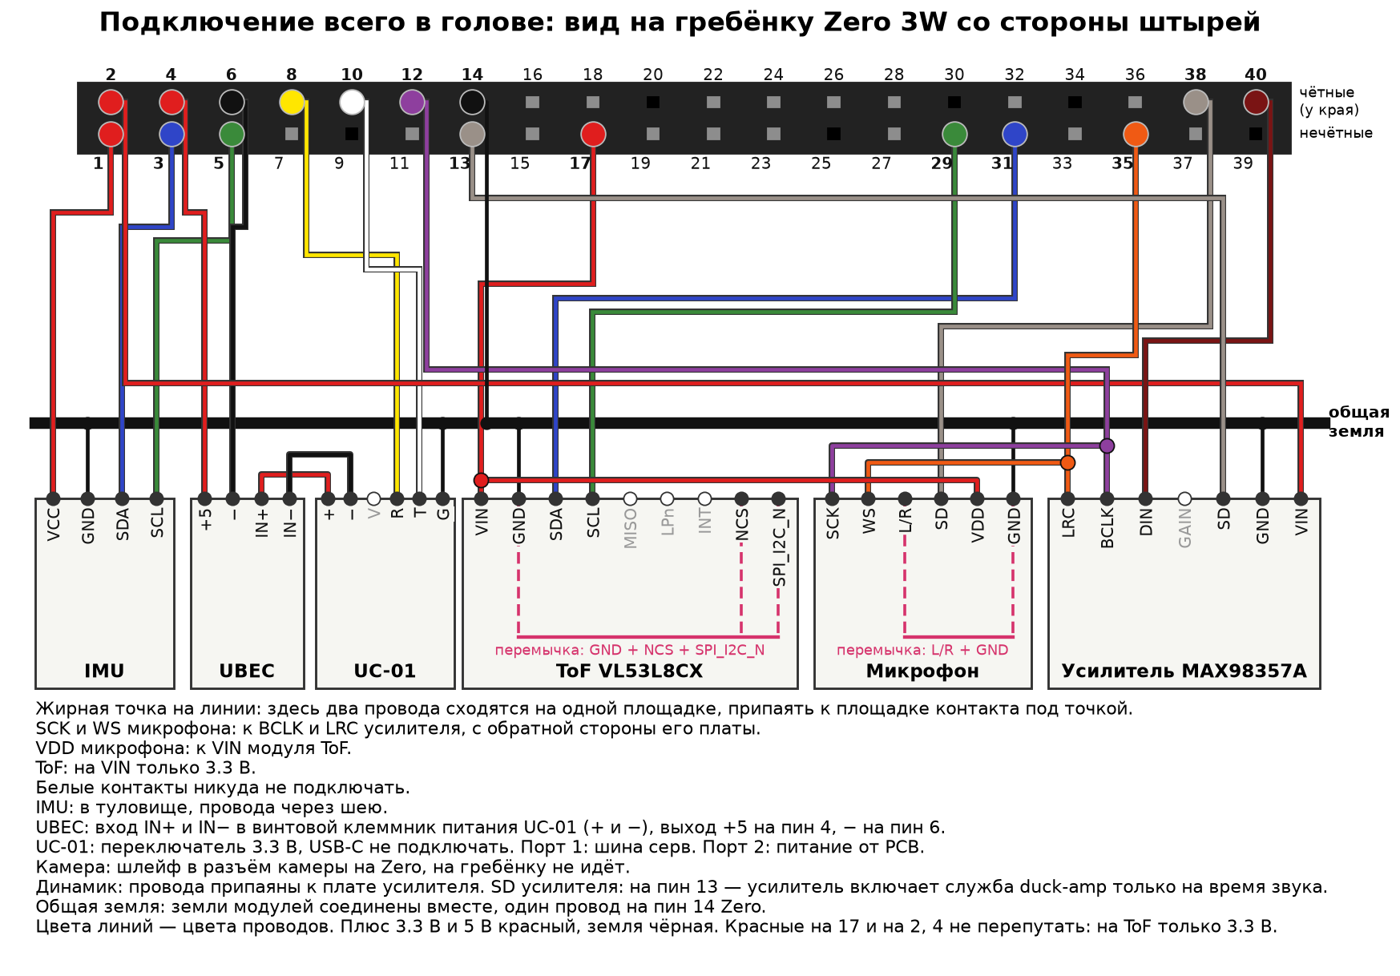
docs/assembly/img/wiring.ru.png
