AleksWolf/kryakva/(commit log)

2026-11-08 Add Fashion Star to manufacturer documents in LICENSE
    The UC-01 schematic from Fashion Star goes into docs/datasheets.
2026-11-09 Publish the duck: CAD, print profiles, guide, software, training
    Everything needed to download, print, buy, build and run the duck:
    assembled STEP files and print profiles, the bill of materials and
    wiring, the PCB, the step-by-step 3D assembly guide, Zero 3W setup with
    robotd, the duck page and the servo console, the three accepted
    policies with training patches. Texts in English and Russian.
    [ankle_axle.stl, ankle_l_v1.stl, ankle_left.stl, ankle_r_v1.stl, ankle_right.stl, assembly.step, assembly_rollers.step, banana_pcb_locker.stl]
2026-11-10 Add ToF crosstalk calibration
    Without it the VL53L8CX reads everything closer than 60 cm as nearer
    than it is. tof_check can now calibrate and load xtalk.bin, the duck
    page uses it when present, and zero_setup has the calibration step.
